RCIA-JASON13/kicad_tst/01_HPM5E00EVKRevC/02_投产资料/HPM5E00EVKRevC_投产资料/5E_EVK_BOM 2025.03.13.xls

5E_EVK_BOM 2025.03.13
null | References | Value | Footprint | ASSY_OPT | Company | Model | Quantity
1 | C5, C6, C10, C13, C14, C15, C17, C20, C25, C32, C39, C40, C44, C46, C49, C57, C59, C65, C66, C74, C75, C80, C84, C85, C88, C89, C91, C92, C93, C94, C95, C97, C99, C100, C101, C103, C105, C112, C114, C115, C116, C121, C122, C129, C131, C132, C133, C134, C135, C139, C140, C142, C143, C154, C172, C247, C248, C249, C250, C251, C253, C254, C255, C256, C257, C264，C12, C72, C73, C113, C124, C127 | 0.1uF,50V | C_0402_1005Metric |  | SAMSUNG(三星) | 0402B104K500NT | 72
2 | C83, C86, C87, C107, C108, C145, C146, C147, C148, C157, C158, C159, C160 | 10nF,50V | C_0402_1005Metric |  | SAMSUNG(三星) | CL05B103KB5NNNC | 13
3 | C110 | 2.2nF,50V | C_0402_1005Metric |  | SAMSUNG(三星) | CL05B222KB5NNNC | 1
4 | C53, C69, C70, C117, C138, C149, C150, C152, C161 | 1nF,2kV | C_1206_3216Metric |  | FH(风华) | 1206B102K202NT | 9
5 | C81, C82, C262, C263 | 12pF,50V | C_0402_1005Metric |  | YAGEO(国巨) | CC0402JRNPO9BN120 | 4
6 | C141, C144 | 18pF,50V | C_0402_1005Metric |  | YAGEO(国巨) | CC0402JRNPO9BN180 | 2
7 | C58, C67, C79 | 47pF,50V | C_0402_1005Metric |  | YAGEO(国巨) | CC0402JRNPO9BN470 | 3
8 | C21, C43 | 22pF,50V | C_0402_1005Metric |  | SAMSUNG(三星) | CL05C220JB5NNNC | 2
9
10 | C16, C258，C18, C27, C28, C33, C45, C47, C51, C52, C62, C68, C76, C77, C78, C98, C104, C106, C109, C119, C125, C156, C245, C246, C252 | 10uF,10V | C_0402_1005Metric |  | SAMSUNG(三星) | CL05A106MP5NUNC | 25
11 | C153，C2, C3, C4, C8, C22, C29, C30, C31, C54, C60, C130, C136, C137, C155 | 10uF,16V | C_0603_1608Metric |  | SAMSUNG(三星) | CL10A106KO8NQNC | 14
12 | C1, C7, C9, C19, C23, C24, C26, C41, C42, C50 | 22uF,16V | C_0805_2012Metric |  | SAMSUNG(三星) | CL21A226MOQNNNE | 10
13 | C90, C96, C102, C111 | 22uF,10V | C_0603_1608Metric |  | SAMSUNG(三星) | CL10A226MP8NUNE | 4
14 | C123 | 0.1uF,16V | C_0402_1005Metric | DNP | SAMSUNG(三星) | CL05B104KO5NNNC | 1
15 | C63, C120 | 0.1uF,50V | C_0402_1005Metric | DNP | SAMSUNG(三星) | 0402B104K500NT | 2
16 | C71, C118 | 1uF,10V | C_0402_1005Metric | DNP | SAMSUNG(三星) | CL05A105KP5NNNC | 2
17 | C55, C56, C61, C64, C126, C128, C151 | 10nF,50V | C_0402_1005Metric | DNP | SAMSUNG(三星) | CL05B103KB5NNNC | 7
18 | C34, C35, C36, C37, C38 | 47pF,50V | C_0402_1005Metric | DNP | YAGEO(国巨) | CC0402JRNPO9BN470 | 5
19 | C11, C48 | 62pF,50V | C_0402_1005Metric | DNP | SAMSUNG(三星) | CL05B104KO5NNNC | 2
20 | R46, R48, R50, R51, R61, R75, R102, R103, R108, R113, R114, R115, R123, R125, R127, R130, R132 | 0Ω | R_0402_1005Metric |  | YAGEO(国巨) | RC0402JR-070RL | 17
21 | R41, R66, R167, R168, R284, R290, R291 | 0Ω_0402 | R_0402_1005Metric |  | YAGEO(国巨) | RC0402JR-070RL | 7
22 | R2, R4 | 0Ω | R_0603_1608Metric |  | UNI-ROYAL(厚声) | 0603WAF0000T5E | 2
23 | R100 | 0Ω | R_0805_2012Metric |  | FH(风华) | RS-05000JT | 1
24 | R53, R67 | 60.4Ω_1206 | R_1206_3216Metric |  | UNI-ROYAL(厚声) | 1206W4F604JT5E | 2
25 | R54, R63 | 49.9Ω | R_0402_1005Metric |  | UNI-ROYAL(厚声) | 0402WGF499JTCE | 2
26 | R97, R109 | 10Ω | R_0402_1005Metric |  | UNI-ROYAL(厚声) | 0402WGF100JTCE | 2
27 | R3, R40, R43, R44, R45, R47, R52, R56, R65, R71, R73, R76, R94, R106, R107, R110, R133, R135, R140, R162, R163, R164, R165, R193, R194, R195, R196 | 33Ω | R_0402_1005Metric |  | UNI-ROYAL(厚声) | 0402WGF330JTCE | 27
28 | R80, R81, R82, R83, R158, R159, R160, R161, R180, R181, R182, R183 | 75Ω_0603 | R_0603_1608Metric |  | UNI-ROYAL(厚声) | 0603WAF750JT5E | 12
29 | R11, R85, R87, R112, R128, R155, R157, R287 | 330Ω | R_0402_1005Metric |  | UNI-ROYAL(厚声) | 0402WGF3300TCE | 8
30 | R169, R170, R171, R172, R173, R174, R175, R176 | 220Ω | R_0402_1005Metric |  | UNI-ROYAL(厚声) | 0402WGF2200TCE | 8
31 | R32, R33, R34, R35, R36 | 100Ω | R_0402_1005Metric |  | UNI-ROYAL(厚声) | 0402WGF1000TCE | 5
32 | R6 | 22Ω | R_0402_1005Metric |  | UNI-ROYAL(厚声) | 0402WGF220JTCE | 1
33 | R79, R153, R178 | 2.49K | R_0402_1005Metric |  | FH(风华) | RC-02W2491FT | 3
34 | R119 | 4.7K | R_0603_1608Metric |  | UNI-ROYAL(厚声) | 0603WAF4701T5E | 1
35 | R29, R62, R64, R84, R86, R122, R138, R139, R141, R142, R143, R144, R145, R146, R147, R148, R149, R151, R154, R156 | 4.7K | R_0402_1005Metric |  | UNI-ROYAL(厚声) | 0402WGF4701TCE | 20
36 | R292, R293 | 5.1K | R_0402_1005Metric |  | UNI-ROYAL(厚声) | 0402WGF5101TCE | 2
37 | R21, R22，R1, R8, R9, R10, R14, R16, R17, R23, R26, R37, R38, R39, R59, R72, R74, R89, R90, R96, R98, R99, R101, R111, R166, R179, R286, R288, R289, R296, R297, R299 | 10K | R_0402_1005Metric |  | UNI-ROYAL(厚声) | 0402WGF1002TCE | 32
38 | R24, R298 | 2K | R_0402_1005Metric |  | UNI-ROYAL(厚声) | 0402WGF2001TCE | 2
39 | R7, R55, R57, R58, R77, R104, R105, R200 | 1K | R_0402_1005Metric |  | UNI-ROYAL(厚声) | 0402WGF1001TCE | 8
40 | R192 | 33.2K | R_0402_1005Metric |  | UNI-ROYAL(厚声) | 0402WGF1003TCE | 1
41 | R285 | 12K | R_0402_1005Metric |  | UNI-ROYAL(厚声) | 0402WGF1202TCE | 1
42 | R12 | 100K | R_0402_1005Metric |  | UNI-ROYAL(厚声) | 0402WGF1003TCE | 1
43 | R93 | 1M | R_0402_1005Metric |  | UNI-ROYAL(厚声) | CQ02WGJ0105TCE | 1
44 | R42, R91, R92,R95 | 1M | R_1206_3216Metric |  | Viking(光颉) | ARG06BTC1004 | 4
45 | R88 | 10K | R_0402_1005Metric | DNP | UNI-ROYAL(厚声) | 0402WGF1002TCE | 1
46 | R116, R137 | 2.49K | R_0402_1005Metric | DNP | FH(风华) | RC-02W2491FT | 2
47 | R150, R152 | 4.7K | R_0402_1005Metric | DNP | UNI-ROYAL(厚声) | 0402WGF4701TCE | 2
48 | R49, R134 | 33Ω | R_0402_1005Metric | DNP | UNI-ROYAL(厚声) | 0402WGF330JTCE | 2
49 | R5, R25 | 0Ω | R_0603_1608Metric | DNP | UNI-ROYAL(厚声) | 0603WAF0000T5E | 2
50 | R18, R19 | 5.1K | R_0402_1005Metric | DNP | UNI-ROYAL(厚声) | 0402WGF5101TCE | 2
51 | R27, R28, R30, R117, R118, R120, R121, R124, R126, R129, R131, R136, R184, R185, R186, R187, R188, R189, R190, R191 | 0Ω | R_0402_1005Metric | DNP | YAGEO(国巨) | RC0402JR-070RL | 20
52 | R13, R15, R20, R31, R60, R68, R69, R70, R78, R177 | 0Ω_0402 | R_0402_1005Metric | DNP | YAGEO(国巨) | RC0402JR-070RL | 10
53 | D1 | 1N5819HW-7-F | D_SOD-123 | DNP | DIODES(美台) | 1N5819HW-7-F | 1
54 | U5 | MX25L12833FM2I-10G | SOIC8_208mil | DNP | MXIC(旺宏电子) | MX25L12833FM2I-10G | 1
55 | L1, L3, L4, L6 | 4.7uH_1.4A | L1008 |  | muRata(村田) | DFE252010F-4R7M | 4
56 | L2, L7 | DLW21SN900SQ2L | L2012 |  | muRata(村田) | DLW21SN900SQ2L | 2
57 | L5 | ACT45B-510-2P-TL003 | L4532 |  | TDK | ACT45B-510-2P-TL003 | 1
58 | D2, D15 | SS34A | D_SMA |  | YANGJIE(扬杰) | SS34A | 2
59 | D3, D5 | BAT54A-7-F | SOT-23 |  | DIODES(美台) | BAT54A-7-F | 2
60 | FB2, FB5, FB6, FB8,FB3, FB10 | 100Ω@100MHz 2A | R_0603_1608Metric |  | Sunlord(顺络) | PZ1608D101-2R0TF | 6
61 | FB1, FB4 | 100Ω@100MHz_2A | R_0805_2012Metric |  | Sunlord(顺络) | PZ2012U101-2R0TF | 2
62 | LED4 | SLR0365CRA1BD | LED-SEG-TH |  | SUNLIGHT(光华) | SLR0365CRA1BD/AFN-3651A | 1
63 | Q1 | 2N7002 | SOT-23 |  | CJ(江苏长电/长晶) | 2N7002 | 1
64 | LED8 | LED_GREEN | LED_0603 |  | 国星光电 | NCD0603C1 | 1
65 | LED1, LED2, LED5, LED6, LED7 | LED_RED | LED_0603 |  | 国星光电 | NCD0603R1 | 5
66 | D7 | NUP2105L | SOT-23 |  | TECH PUBLIC(台舟) | NUP2105L | 1
67 | U6, U29 | PW1515 | SOT-23-5 |  | 平芯微 | PW1515 | 2
68 | U7, U30 | PRTR5V0U2X | SOT-143 |  | TECH PUBLIC(台舟) | PRTR5V0U2X | 2
69 | U11, U22 | JL1111-N032I | QFN-32-1EP_5x5mm |  | JLSEMI/景略 | JL1111-N032I | 2
70 | U20, U21 | 74HC595D,118 | SOIC-16 |  | Nexperia(安世) | 74HC595D,118 | 2
71 | U1 | TPS563201DDCR | SOT-23-6 |  | TI | TPS563201DDCR | 1
72 | U2 | REF3033AIDBZR | SOT-23 |  | TI | REF3033AIDBZR | 1
73 | U3 | 74HC165D,653 | SOIC-16 |  | Nexperia(安世) | 74HC165D,653 | 1
74 | U4 | HPM5E31IGN1 | BGA-196_14x14 |  |  |  | 1
75
76 | U8 | AP2151WG-7 | SOT-23-5 |  | DIODES(美台) | AP2151WG-7 | 1
77 | U9 | NSI1306M25-DSWR | SOP-16_L10.3 |  | NOVOSENSE(纳芯微) | NSI1306M25-DSWR | 1
78 | U10 | CAT24C128WI-GT3 | SOIC-8 |  | onsemi(安森美) | CAT24C128WI-GT3 | 1
79 | U12 | TLV62569DBVR | SOT-23-5 |  | TI | TLV62569DBVR | 1
80 | U13 | LP5907MFX-3.3/NOPB | SOT-23-5 |  | TI | LP5907MFX-3.3/NOPB | 1
81 | U15 | RTL8211E-VB-CG | QFN-48-1EP_6x6mm |  | REALTEK(瑞昱) | RTL8211E-VB-CG | 1
82 | U16 | 网口变压器H5007NL | PULSE_H5007NL |  | PULSE | H5007NL | 1
83 | U17 | TJA1042T/3 | SOIC-8 |  | NXP(恩智浦) | TJA1042T/3 | 1
84 | U18 | DS18B20 | TO-92-3 |  | MSKSEMI(美森科) | DS18B20 | 1
85 | U28 | FT2232HL | LQFP-64 |  | FTDI(飞特帝亚) | FT2232HL | 1
86 | U31 | 93LC56B-I/SN | SOIC-8 |  | MICROCHIP(美国微芯) | 93LC56B-I/SN | 1
87 | X2 | 24MHz ±10ppm 12pF | 3225 |  | EPSON(爱普生) | X1E0000210129 | 1
88 | X5 | 25MHz_±10ppm_12pF | 3225 |  | YXC(扬兴晶振) | X322525MOB4SI | 1
89 | X6 | 12MHz ±10ppm 10pF | 3225 |  | HCI(杭晶) | XC32M4-12.000-F10NNFT | 1
90 | SW2, SW4, SW5, SW7, SW8, SW9, SW10, SW11, SW12 | 轻触开关4.5mm*4.5mm*4mm | 轻触开关SMD-4P,4.5x4.5mm |  | SHOU HAN(首韩) | TS4540TP | 9
91 | SW1, SW6 | 拨码开关 | SW-SMD_DM-02-V |  | 圜达 | DM-02-V | 2
92 | SW3 | 轻触开关 | 轻触开关SMD-4P,4.5x4.5mm |  | E-Switch | TL3305AF260QG | 1
93 | T3, T30 | 网口变压器11FB-05NL | H1102_XFMR16_SM |  | YDS(元册科技) | 11FB-05NL | 2
94 | CN1 | 3113-112T | SMD_98P-P1.00-V_3133 |  | UMaxconn(友贸) | 3113-112T | 1
95 | J1, J16 | USB_Type-C | TYPE-C-16P |  | kinghelm(金航标) | KH-TYPE-C-16P | 2
96 | J4, J5 | SMA内孔弯座 | SMA-弯座 |  | kinghelm(金航标) | KH-SMA-K513-G | 2
97 | J6, J8 | 测试针 | 探针 |  | Keystone | 4952 | 2
98 | J7 | KF2EDGR_3.81_3P | 3.81_1x03_P3.81mm |  | BOOMELE(博穆精密) | 2.54-1*40P直针 | 1
99 | J10 | 2.54-2*10P简牛 | IDC-Header_2x10_P2.54mm |  | BOOMELE(博穆精密) | 2.54-2*10P简牛 | 1
100 | P1, P2,P3 | RJ45 | RJ45-TH_B-1-1_led-update |  | BOOMELE(博穆精密) | RJ45-B-1*1 | 2
101 | JP1, JP2, JP4, JP5, JP6, JP7, JP8, JP21 | Jumper_2 | 1x02_P2.54mm_Vertical |  |  | 跳帽 | 8
102 | JP3 | Jumper_3_Bridged12 | 1x03_P2.54mm_Vertical |  |  | 跳帽(2-3) | 1
103 | J17 | Conn_01x10 | 1x10_P2.54mm_Vertical |  | XFCN(兴飞) | PZ254V-11-06P | 1
104 | P5 | 双排排针2.54mm-40P | 2x20_P2.54mm_Vertical |  | BOOMELE(博穆精密) | 2.54mm 2*20P直排针 | 1
105 | J3 | Conn_02x16_90° | 2x16_P2.54mm_Horizontal |  | BOOMELE(博穆精密) | 2.54-2*16P弯针 | 1
