RCIA-JASON13/kicad_tst/01_HPM5E00EVKRevC/02_投产资料/HPM5E00EVKRevC_投产资料/外观图.pdf

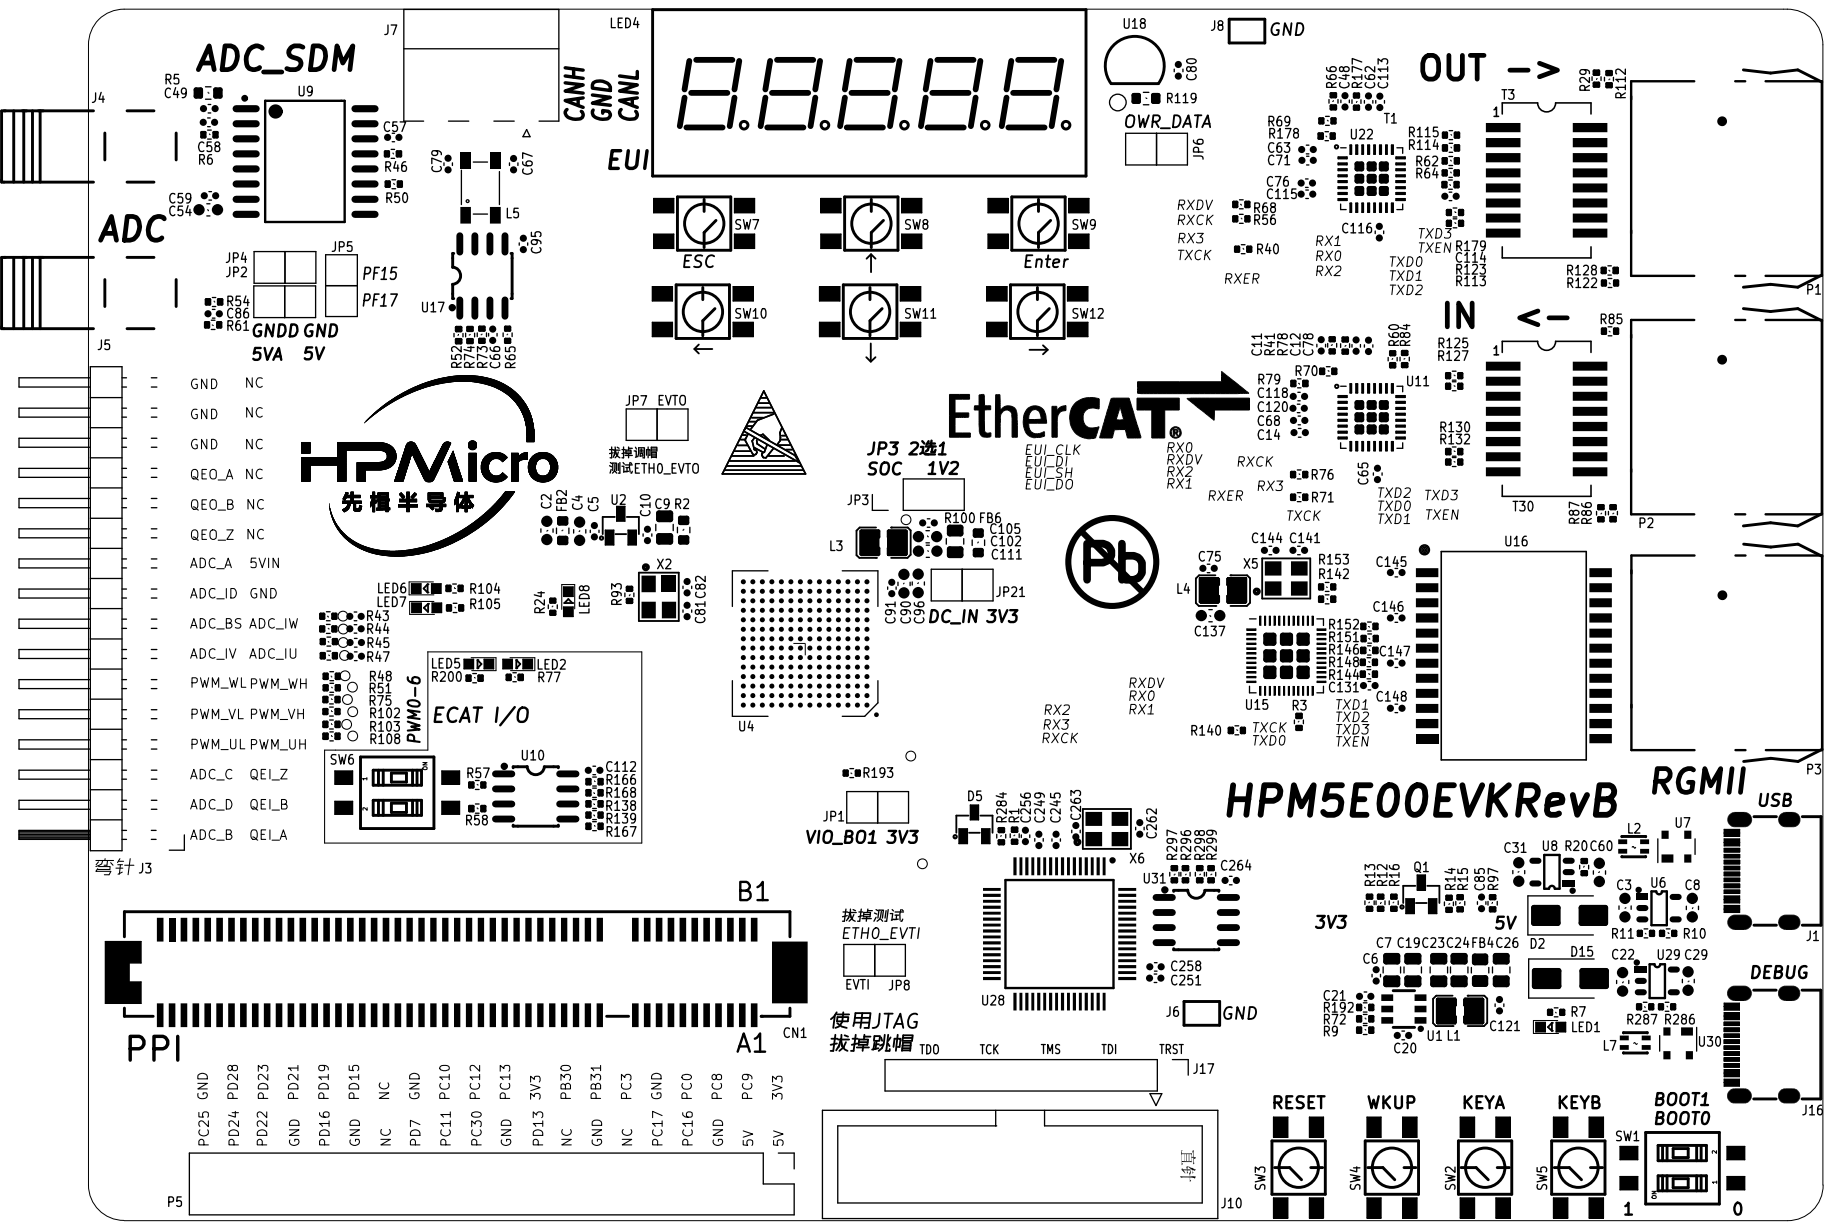
[picture p1: page 1]
