RCIA-JASON13/kicad_tst/01_HPM5E00EVKRevC/01_工程文件/HPM5E00EVKRevC/01.MAIN.kicad_sch

## KiCad design 01_HPM5E00EVKRevC/01_工程文件/HPM5E00EVKRevC/01.MAIN.kicad_sch (2026-01-12)

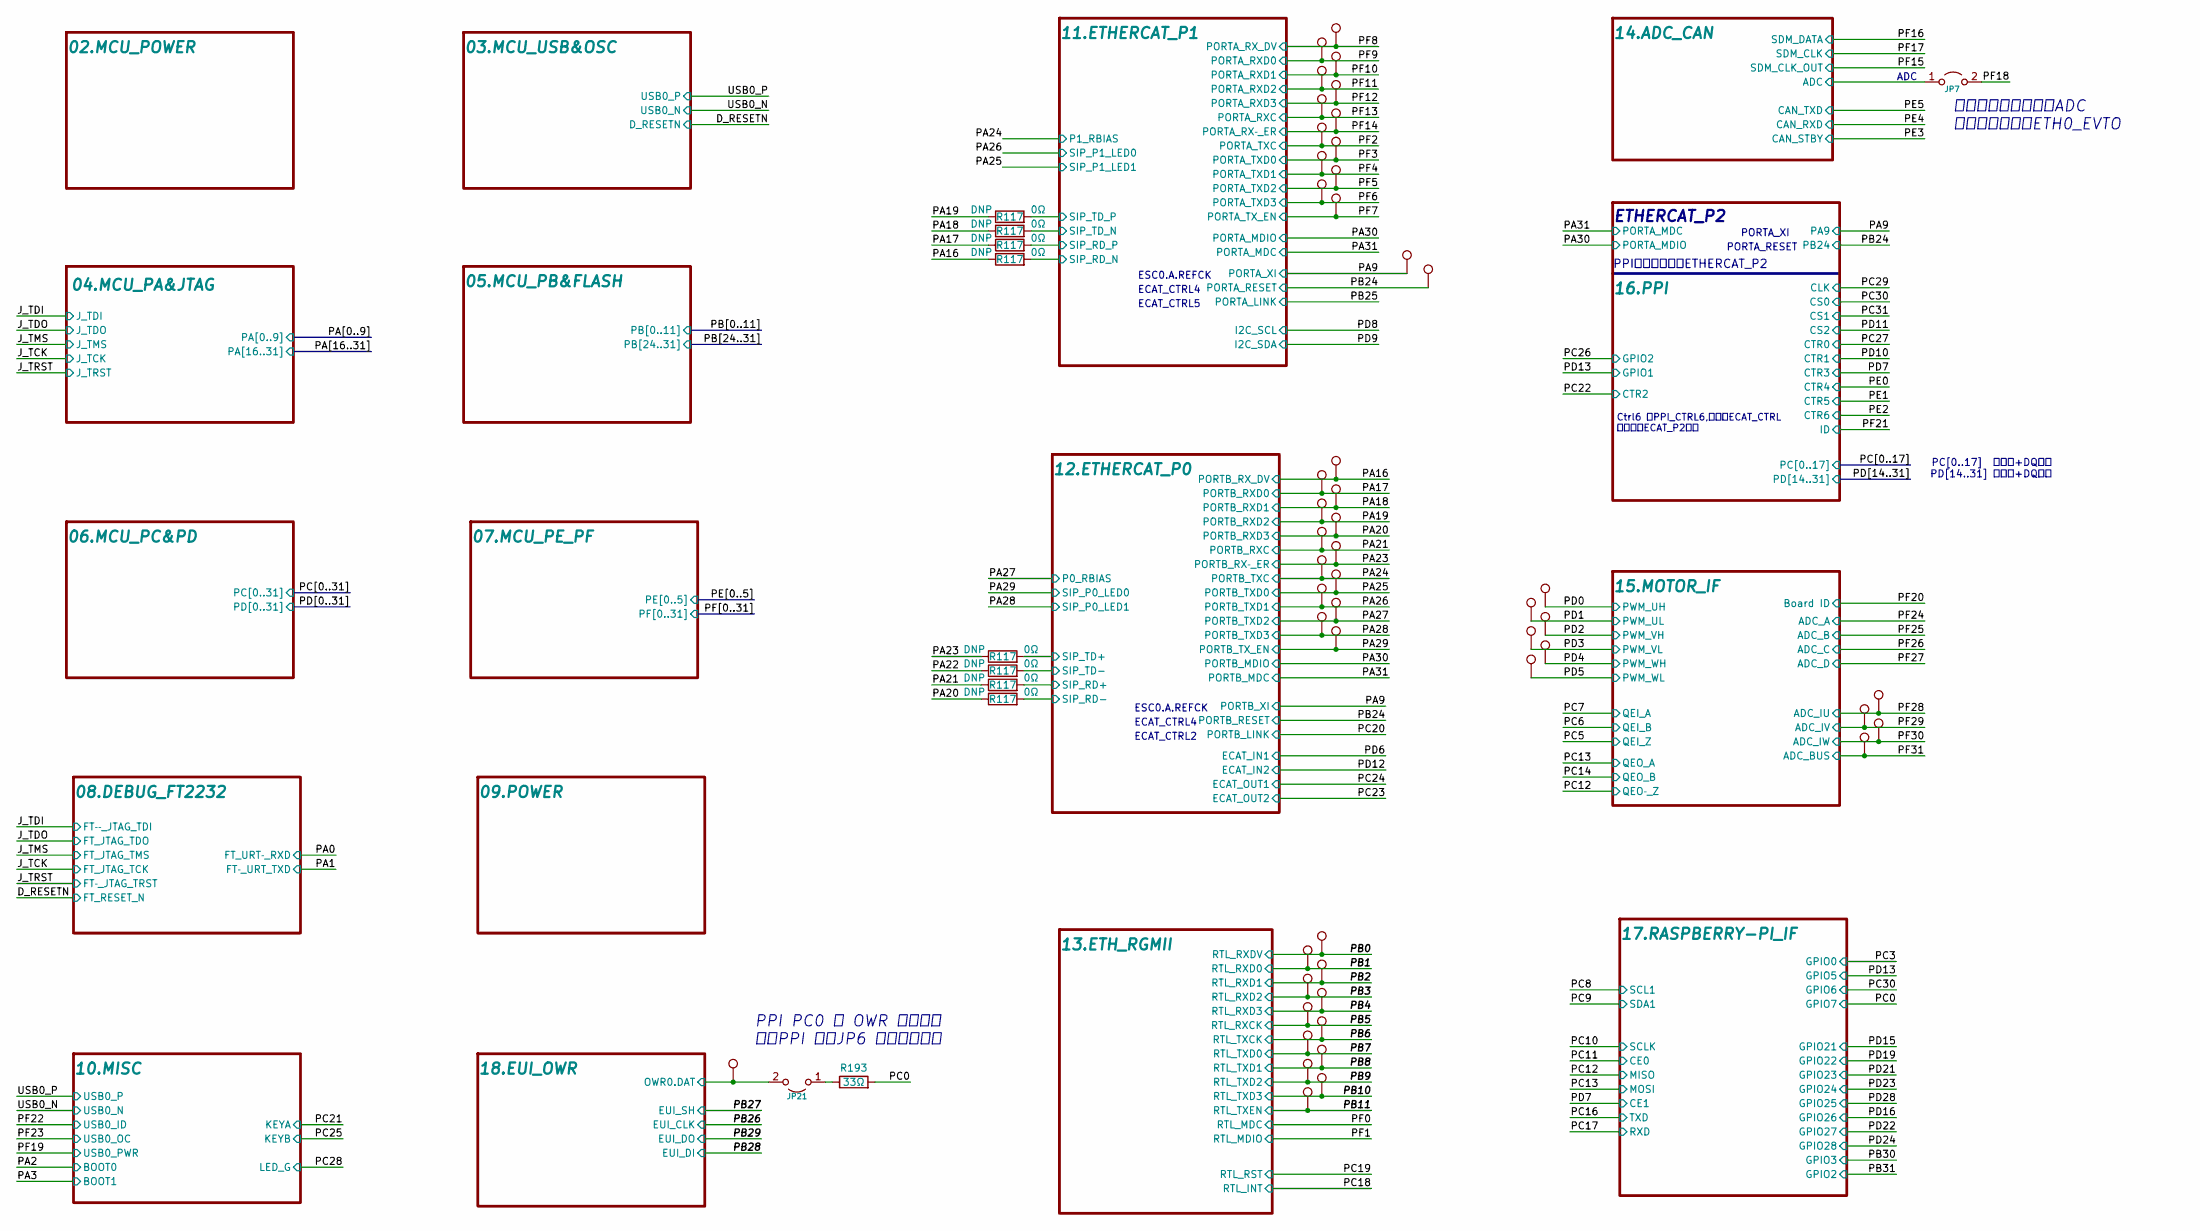
[picture p2: schematic 01.MAIN.kicad_sch]

Parts:
JP7, JP21: Jumper_2; PinHeader_1x02_P2.54mm_Vertical
R117: 0Ω; R_0402_1005Metric
R193: 33Ω; R_0402_1005Metric
TP1, TP2, TP3, TP4, TP5, TP6, TP7, TP8, TP9, TP10, TP11, TP12, TP13, TP14, TP15, TP16, TP17, TP18, TP19, TP20, TP21, TP22, TP23, TP24, TP25, TP26, TP27, TP28, TP29, TP30, TP31, TP32, TP33, TP34, TP35, TP36, TP37, TP38, TP46, TP47, TP48, TP49, TP50, TP51, TP52, TP53, TP54, TP55, TP56, TP57: 0.5mm; TestPoint_Pad_D0.5mm
TP42: 1.0mm; TestPoint_Pad_D1.0mm

Connections:
ADC: JP7.1 (A)
unnamed: JP21.1 (A), R193.1
OWR0.DAT: JP21.2 (B), TP42.1
PA9: TP46.1
PA16: R117.1, TP13.1
PA17: R117.1, TP14.1
PA18: R117.1, TP15.1
PA19: R117.1, TP16.1
PA20: R117.1, TP17.1
PA21: R117.1, TP18.1
PA22: R117.1
PA23: R117.1, TP19.1
PA24: TP20.1
PA25: TP21.1
PA26: TP22.1
PA27: TP23.1
PA28: TP24.1
PA29: TP25.1
PB0: TP1.1
PB1: TP2.1
PB2: TP3.1
PB3: TP4.1
PB4: TP5.1
PB5: TP6.1
PB6: TP7.1
PB7: TP8.1
PB8: TP9.1
PB9: TP10.1
PB10: TP11.1
PB11: TP12.1
PB24: TP47.1
PC0: R193.2
PD0: TP48.1
PD1: TP49.1
PD2: TP50.1
PD3: TP51.1
PD4: TP52.1
PD5: TP53.1
PF2: TP33.1
PF3: TP34.1
PF4: TP35.1
PF5: TP36.1
PF6: TP37.1
PF7: TP38.1
PF8: TP26.1
PF9: TP27.1
PF10: TP28.1
PF11: TP29.1
PF12: TP30.1
PF13: TP31.1
PF14: TP32.1
PF18: JP7.2 (B)
PF28: TP54.1
PF29: TP55.1
PF30: TP56.1
PF31: TP57.1
SIP_RD+: R117.2
SIP_RD-: R117.2
SIP_RD_N: R117.2
SIP_RD_P: R117.2
SIP_TD+: R117.2
SIP_TD-: R117.2
SIP_TD_N: R117.2
SIP_TD_P: R117.2

Notes on the sheet:
Ctrl6 是PPI_CTRL6,同时是ECAT_CTRL 该引脚给ECAT_P2使用
PPI PC0 与 OWR 引脚重合 测试PPI 时候JP6 不要插上跳冒
ECAT_CTRL5
PORTA_XI
插上跳冒，默认测试ADC 拔掉调帽，测试ETH0_EVTO
PPI子卡上会增加ETHERCAT_P2
ECAT_CTRL4
PC[0..17] 数据线+DQ等长 PD[14..31] 数据线+DQ等长
ESC0.A.REFCK
ECAT_CTRL4
PORTA_RESET
ADC
ECAT_CTRL2
ETHERCAT_P2
