RCIA-JASON13/kicad_tst/01_HPM5E00EVKRevC/01_工程文件/HPM5E00EVKRevC/02.MCU_POWER.kicad_sch

## KiCad design 01_HPM5E00EVKRevC/01_工程文件/HPM5E00EVKRevC/02.MCU_POWER.kicad_sch (2026-01-12)

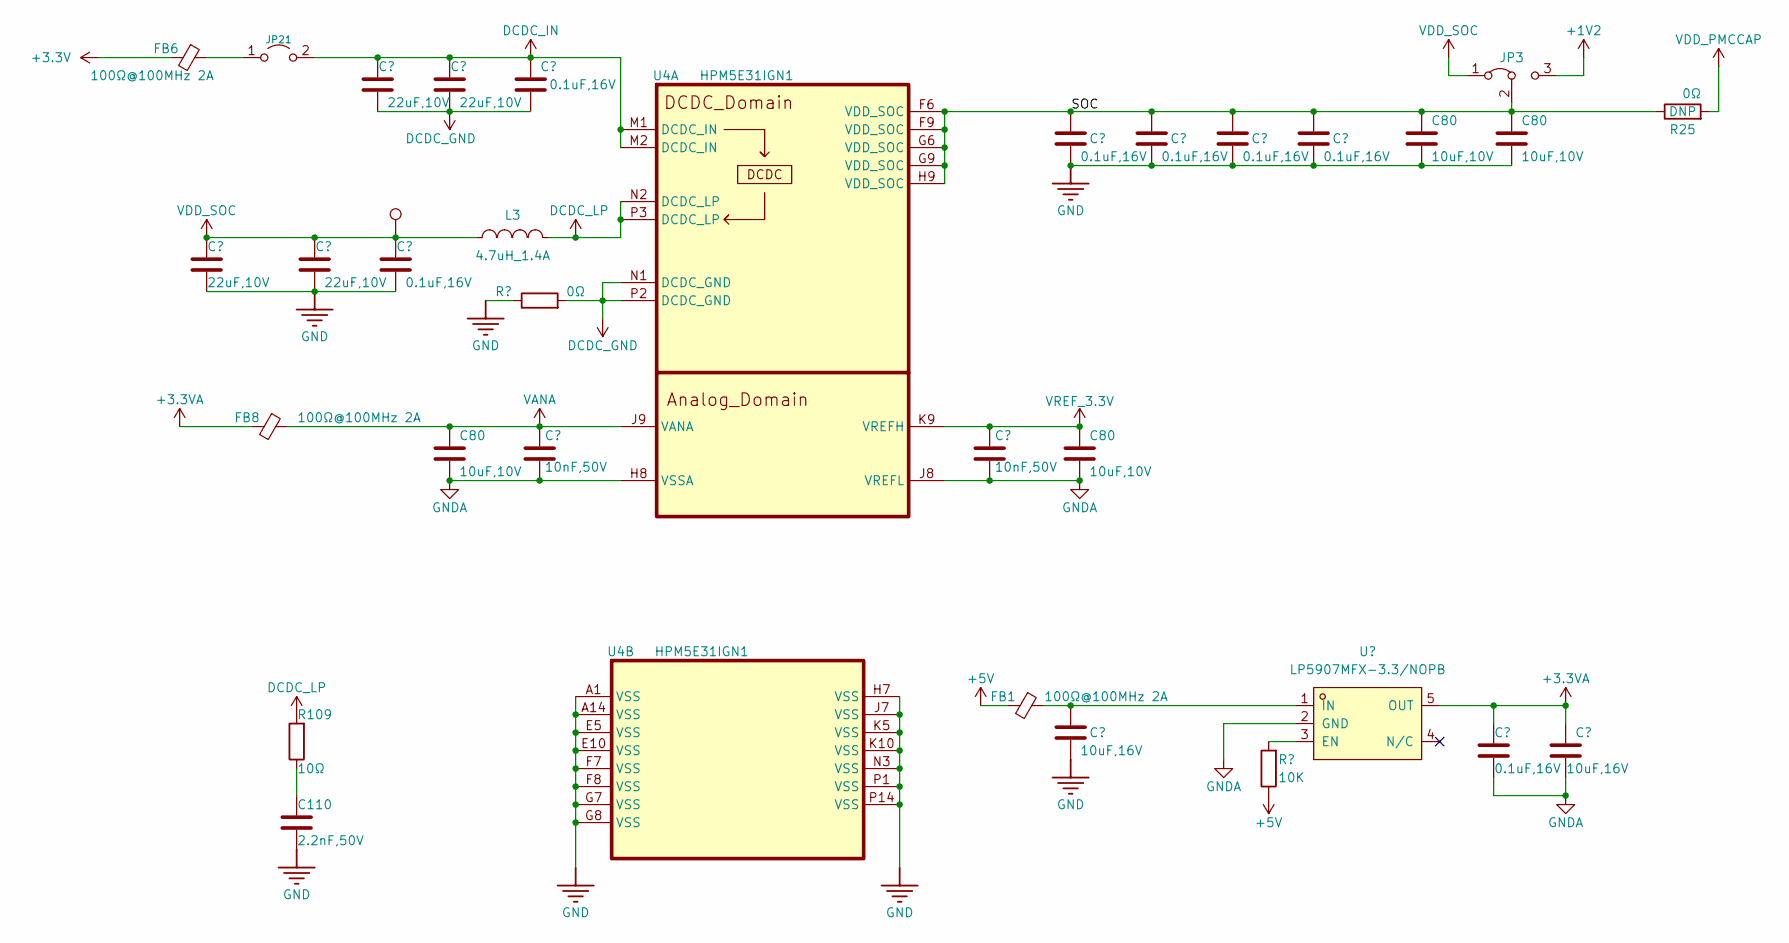
[picture p3: schematic 02.MCU_POWER.kicad_sch]

Parts:
C1, C7: 10uF,16V; C_0603_1608Metric
C6, C91, C92, C93, C94, C97, C105: 0.1uF,16V; C_0402_1005Metric
C80: 10uF,10V; C_0402_1005Metric
C90, C96, C102, C111: 22uF,10V; C_0603_1608Metric
C110: 2.2nF,50V; C_0402_1005Metric
C145: 10nF,50V; C_0402_1005Metric
FB1, FB6, FB8: 100Ω@100MHz 2A; R_0603_1608Metric
JP3: Jumper_3_Bridged12; PinHeader_1x03_P2.54mm_Vertical
JP21: Jumper_2; PinHeader_1x02_P2.54mm_Vertical
L3: 4.7uH_1.4A; L1008
R1: 10K; R_0402_1005Metric
R25: 0Ω; R_0603_1608Metric
R100: 0Ω; R_0805_2012Metric
R109: 10Ω; R_0402_1005Metric
TP58: 0.5mm; TestPoint_Pad_D0.5mm
U1: LP5907MFX-3.3/NOPB; SOT-23-5
U4: HPM5E31IGN1; BGA-196_14x14_12.0x12.0mm_P0.8mm

Connections:
+1V2: JP3.3 (B)
+3.3V: FB6.2
+3.3VA: C6.1, C7.1, FB8.2, U1.5 (OUT)
+5V: FB1.2, R1.1
DCDC_GND: C90.2, C91.2, C96.2, R100.2, U4.N1 (DCDC_GND), U4.P2 (DCDC_GND)
DCDC_IN: C90.1, C91.1, C96.1, JP21.2 (B), U4.M1 (DCDC_IN), U4.M2 (DCDC_IN)
DCDC_LP: L3.2, R109.2, U4.N2 (DCDC_LP), U4.P3 (DCDC_LP)
GND: C1.2, C80.2, C92.2, C93.2, C94.2, C97.2, C102.2, C105.2, C110.2, C111.2, R100.1, U4.A1 (VSS), U4.A14 (VSS), U4.E5 (VSS), U4.E10 (VSS), U4.F7 (VSS), U4.F8 (VSS), U4.G7 (VSS), U4.G8 (VSS), U4.H7 (VSS), U4.J7 (VSS), U4.K5 (VSS), U4.K10 (VSS), U4.N3 (VSS), U4.P1 (VSS), U4.P14 (VSS)
GNDA: C6.2, C7.2, C80.2, C145.2, U1.2 (GND), U4.H8 (VSSA), U4.J8 (VREFL)
unnamed: C1.1, FB1.1, U1.1 (IN)
unnamed: C110.1, R109.1
unnamed: FB6.1, JP21.1 (A)
unnamed: R1.2, U1.3 (EN)
SOC: C80.1, C92.1, C93.1, C94.1, C97.1, JP3.2 (C), R25.1, U4.F6 (VDD_SOC), U4.F9 (VDD_SOC), U4.G6 (VDD_SOC), U4.G9 (VDD_SOC), U4.H9 (VDD_SOC)
VANA: C80.1, C145.1, FB8.1, U4.J9 (VANA)
VDD_PMCCAP: R25.2
VDD_SOC: C102.1, C105.1, C111.1, JP3.1 (A), L3.1, TP58.1
VREF_3.3V: C80.1, C145.1, U4.K9 (VREFH)
