RCIA-JASON13/kicad_tst/01_HPM5E00EVKRevC/01_工程文件/HPM5E00EVKRevC/03.MCU_USB&OSC.kicad_sch

## KiCad design 01_HPM5E00EVKRevC/01_工程文件/HPM5E00EVKRevC/03.MCU_USB&OSC.kicad_sch (2026-01-12)

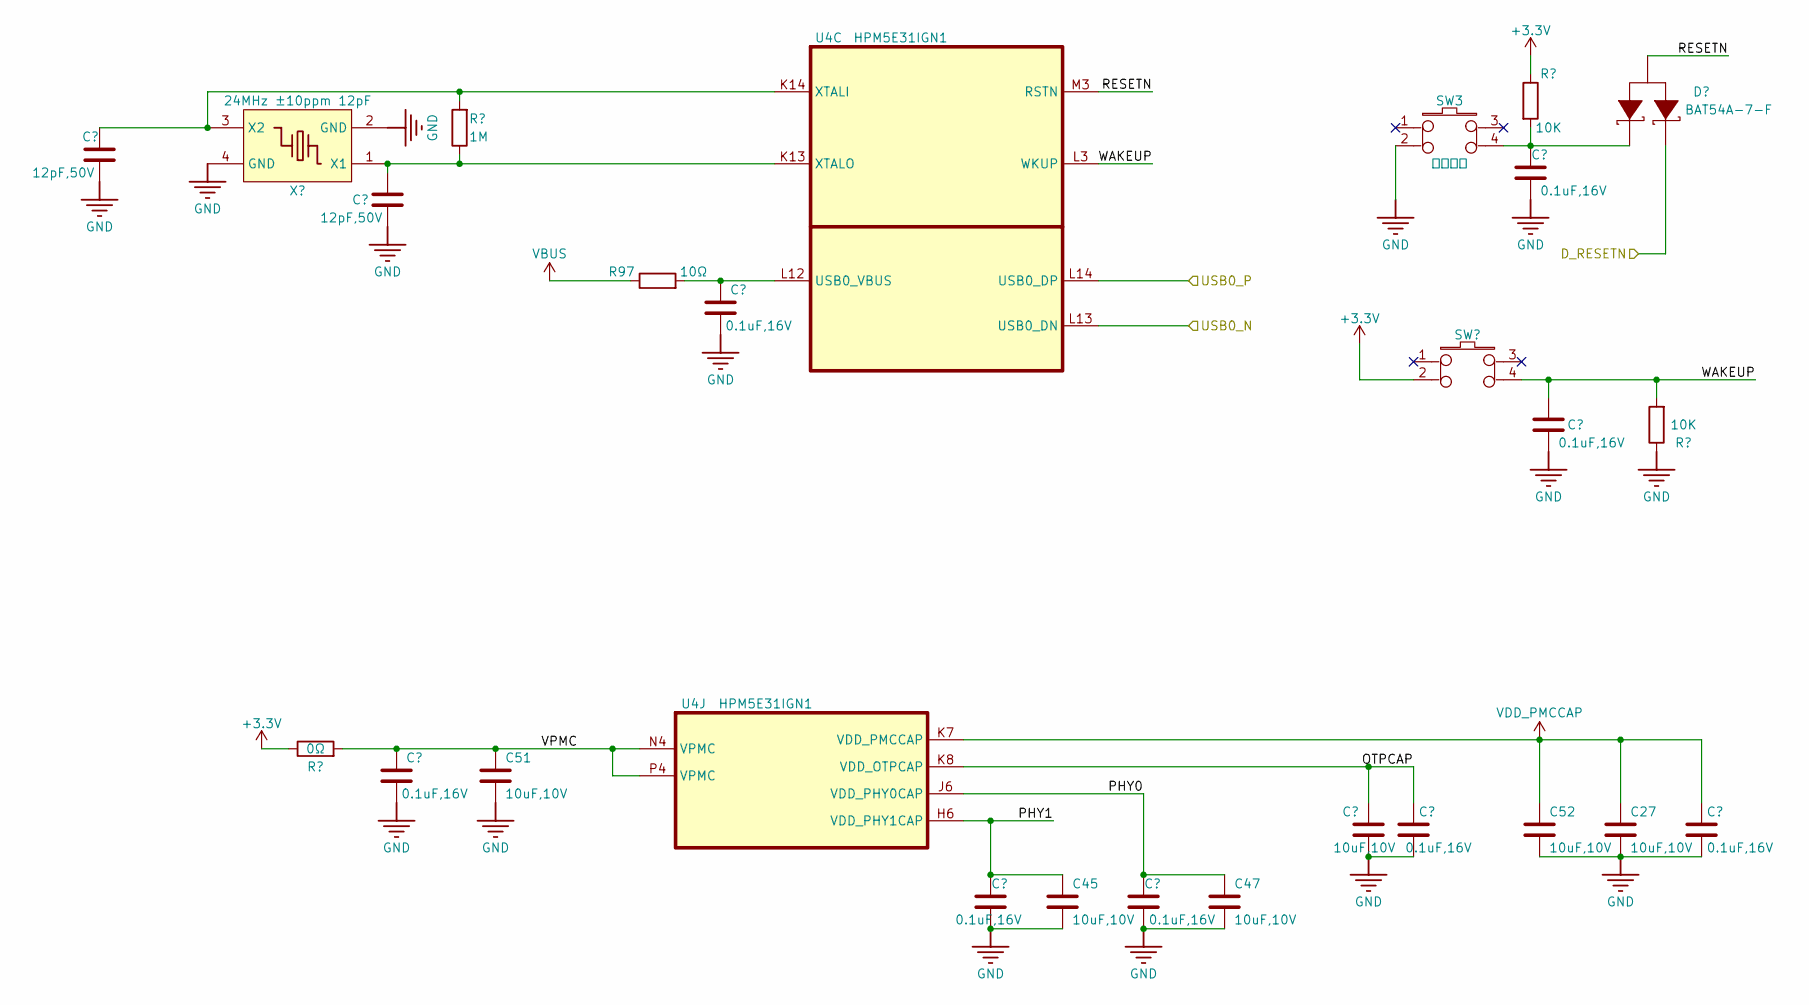
[picture p4: schematic 03.MCU_USB&OSC.kicad_sch]

Parts:
C13, C17, C40, C44, C46, C85, C88, C89: 0.1uF,16V; C_0402_1005Metric
C16, C27, C45, C47, C51, C52: 10uF,10V; C_0402_1005Metric
C81, C82: 12pF,50V; C_0402_1005Metric
D5: BAT54A-7-F; SOT-23
R4: 0Ω; R_0603_1608Metric
R93: 1M; R_0402_1005Metric
R97: 10Ω; R_0402_1005Metric
R98, R99: 10K; R_0402_1005Metric
SW3: 轻触开关; 轻触开关SMD-4P,4.5x4.5mm
SW4: 轻触开关4.5mm*4.5mm*4mm; 轻触开关SMD-4P,4.5x4.5mm
U4: HPM5E31IGN1; BGA-196_14x14_12.0x12.0mm_P0.8mm
X2: 24MHz ±10ppm 12pF; 3225

Connections:
+3.3V: R4.1, R98.1, SW4.2
D_RESETN: D5.2 (A)
GND: C13.1, C16.2, C17.2, C27.2, C40.2, C44.2, C45.2, C46.2, C47.2, C51.2, C52.2, C81.2, C82.2, C85.2, C88.2, C89.2, R99.1, SW3.2, X2.2 (GND), X2.4 (GND)
unnamed: C81.1, R93.2, U4.K14 (XTALI), X2.3 (X2)
unnamed: C82.1, R93.1, U4.K13 (XTALO), X2.1 (X1)
unnamed: C85.1, R97.2, U4.L12 (USB0_VBUS)
unnamed: C88.1, D5.1 (A), R98.2, SW3.4
OTPCAP: C16.1, C17.1, U4.K8 (VDD_OTPCAP)
PHY0: C46.1, C47.1, U4.J6 (VDD_PHY0CAP)
PHY1: C44.1, C45.1, U4.H6 (VDD_PHY1CAP)
RESETN: D5.3 (K), U4.M3 (RSTN)
USB0_N: U4.L13 (USB0_DN)
USB0_P: U4.L14 (USB0_DP)
VBUS: R97.1
VDD_PMCCAP: C27.1, C40.1, C52.1, U4.K7 (VDD_PMCCAP)
VPMC: C13.2, C51.1, R4.2, U4.N4 (VPMC), U4.P4 (VPMC)
WAKEUP: C89.1, R99.2, SW4.4, U4.L3 (WKUP)
