RCIA-JASON13/kicad_tst/01_HPM5E00EVKRevC/01_工程文件/HPM5E00EVKRevC/04.MCU_PA&JTAG.kicad_sch

## KiCad design 01_HPM5E00EVKRevC/01_工程文件/HPM5E00EVKRevC/04.MCU_PA&JTAG.kicad_sch (2026-01-12)

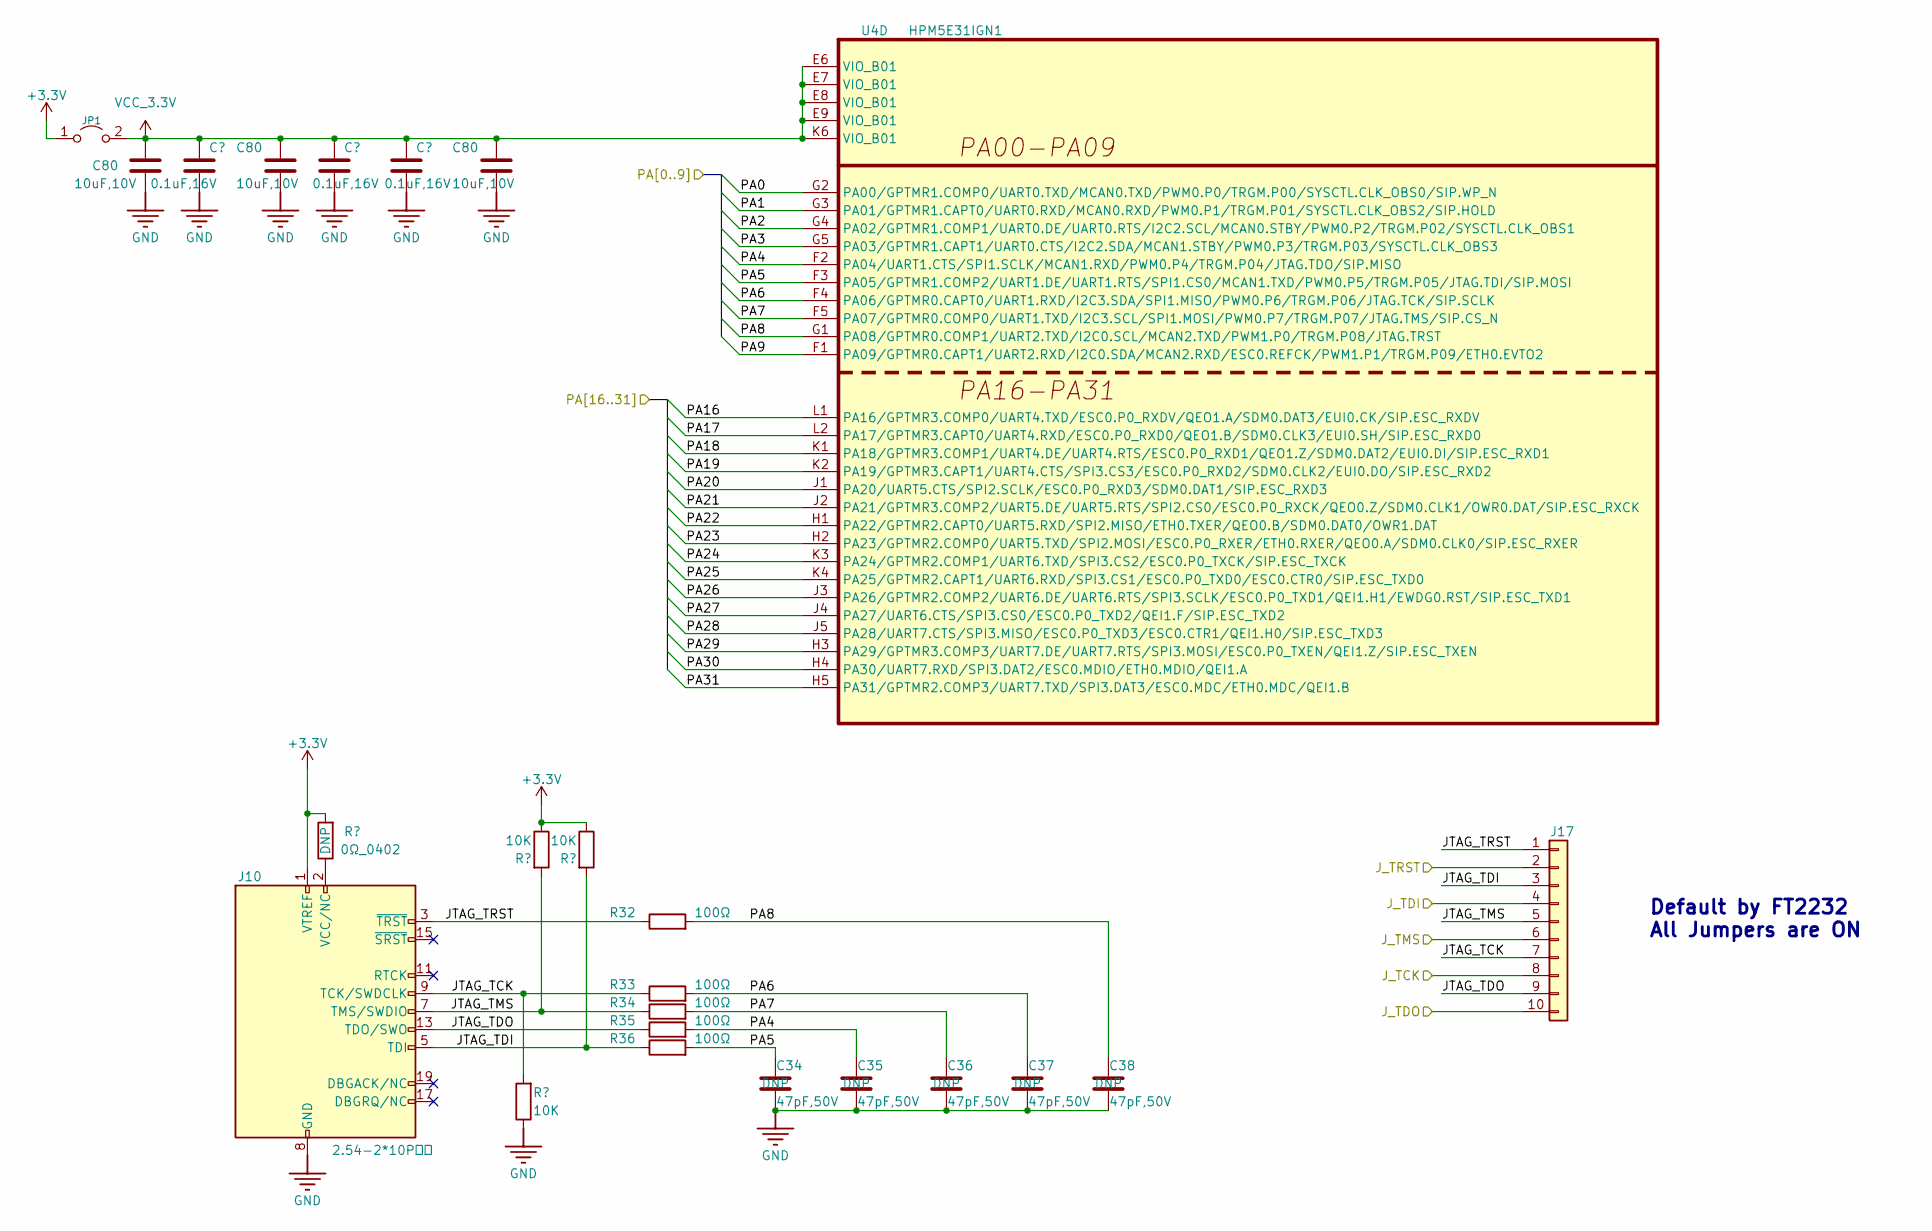
[picture p5: schematic 04.MCU_PA&JTAG.kicad_sch]

Parts:
C25, C84, C99: 0.1uF,16V; C_0402_1005Metric
C34, C35, C36, C37, C38: 47pF,50V; C_0402_1005Metric
C80: 10uF,10V; C_0402_1005Metric
J10: 2.54-2*10P简牛; IDC-Header_2x10_P2.54mm
J17: Conn_01x10; PinHeader_1x10_P2.54mm_Vertical
JP1: Jumper_2; PinHeader_1x02_P2.54mm_Vertical
R31: 0Ω_0402; R_0402_1005Metric
R32, R33, R34, R35, R36: 100Ω; R_0402_1005Metric
R37, R38, R39: 10K; R_0402_1005Metric
U4: HPM5E31IGN1; BGA-196_14x14_12.0x12.0mm_P0.8mm

Connections:
+3.3V: J10.1 (VTREF), JP1.1 (A), R31.2, R38.1, R39.1
GND: C25.1, C34.2, C35.2, C36.2, C37.2, C38.2, C80.2, C84.1, C99.1, J10.8 (GND), R37.1
JTAG_TCK: J10.9 (TCK/SWDCLK), J17.7, R33.1, R37.2
JTAG_TDI: J10.5 (TDI), J17.3, R36.1, R39.2
JTAG_TDO: J10.13 (TDO/SWO), J17.9, R35.1
JTAG_TMS: J10.7 (TMS/SWDIO), J17.5, R34.1, R38.2
JTAG_TRST: J10.3 (~TRST), J17.1, R32.1
J_TCK: J17.8
J_TDI: J17.4
J_TDO: J17.10
J_TMS: J17.6
J_TRST: J17.2
unnamed: J10.2 (VCC/NC), R31.1
PA0: U4.G2 (PA00/GPTMR1.COMP0/UART0.TXD/MCAN0.TXD/P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)
PA1: U4.G3 (PA01/GPTMR1.CAPT0/UART0.RXD/MCAN0.RXD/P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)
PA2: U4.G4 (PA02/GPTMR1.COMP1/UART0.DE/UART0.RTS/I2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)
PA3: U4.G5 (PA03/GPTMR1.CAPT1/UART0.CTS/I2C2.SDA/MC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)
PA4: C35.1, R35.2, U4.F2 (PA04/UART1.CTS/SPI1.SCLK/MCAN1.RXD/PWM0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)
PA5: C34.1, R36.2, U4.F3 (PA05/GPTMR1.COMP2/UART1.DE/UART1.RTS/SP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)
PA6: C37.1, R33.2, U4.F4 (PA06/GPTMR0.CAPT0/UART1.RXD/I2C3.SDA/SP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)
PA7: C36.1, R34.2, U4.F5 (PA07/GPTMR0.COMP0/UART1.TXD/I2C3.SCL/SP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)
PA8: C38.1, R32.2, U4.G1 (PA08/GPTMR0.COMP1/UART2.TXD/I2C0.SCL/MC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)
PA9: U4.F1 (PA09/GPTMR0.CAPT1/UART2.RXD/I2C0.SDA/MC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)
PA16: U4.L1 (PA16/GPTMR3.COMP0/UART4.TXD/ESC0.P0_RXD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)
PA17: U4.L2 (PA17/GPTMR3.CAPT0/UART4.RXD/ESC0.P0_RXD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)
PA18: U4.K1 (PA18/GPTMR3.COMP1/UART4.DE/UART4.RTS/ES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)
PA19: U4.K2 (PA19/GPTMR3.CAPT1/UART4.CTS/SPI3.CS3/ES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)
PA20: U4.J1 (PA20/UART5.CTS/SPI2.SCLK/ESC0.P0_RXD3/S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)
PA21: U4.J2 (PA21/GPTMR3.COMP2/UART5.DE/UART5.RTS/SP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)
PA22: U4.H1 (PA22/GPTMR2.CAPT0/UART5.RXD/SPI2.MISO/E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)
PA23: U4.H2 (PA23/GPTMR2.COMP0/UART5.TXD/SPI2.MOSI/E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)
PA24: U4.K3 (PA24/GPTMR2.COMP1/UART6.TXD/SPI3.CS2/ES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)
PA25: U4.K4 (PA25/GPTMR2.CAPT1/UART6.RXD/SPI3.CS1/ES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)
PA26: U4.J3 (PA26/GPTMR2.COMP2/UART6.DE/UART6.RTS/SP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)
PA27: U4.J4 (PA27/UART6.CTS/SPI3.CS0/ESC0.P0_TXD2/QE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)
PA28: U4.J5 (PA28/UART7.CTS/SPI3.MISO/ESC0.P0_TXD3/E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)
PA29: U4.H3 (PA29/GPTMR3.COMP3/UART7.DE/UART7.RTS/SP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)
PA30: U4.H4 (PA30/UART7.RXD/SPI3.DAT2/ESC0.MDIO/ETH0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)
PA31: U4.H5 (PA31/GPTMR2.COMP3/UART7.TXD/SPI3.DAT3/E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)
VCC_3.3V: C25.2, C80.1, C84.2, C99.2, JP1.2 (B), U4.E6 (VIO_B01), U4.E7 (VIO_B01), U4.E8 (VIO_B01), U4.E9 (VIO_B01), U4.K6 (VIO_B01)

Notes on the sheet:
Default by FT2232 All Jumpers are ON
