RCIA-JASON13/kicad_tst/01_HPM5E00EVKRevC/01_工程文件/HPM5E00EVKRevC/05.MCU_PB&FLASH.kicad_sch

## KiCad design 01_HPM5E00EVKRevC/01_工程文件/HPM5E00EVKRevC/05.MCU_PB&FLASH.kicad_sch (2026-01-12)

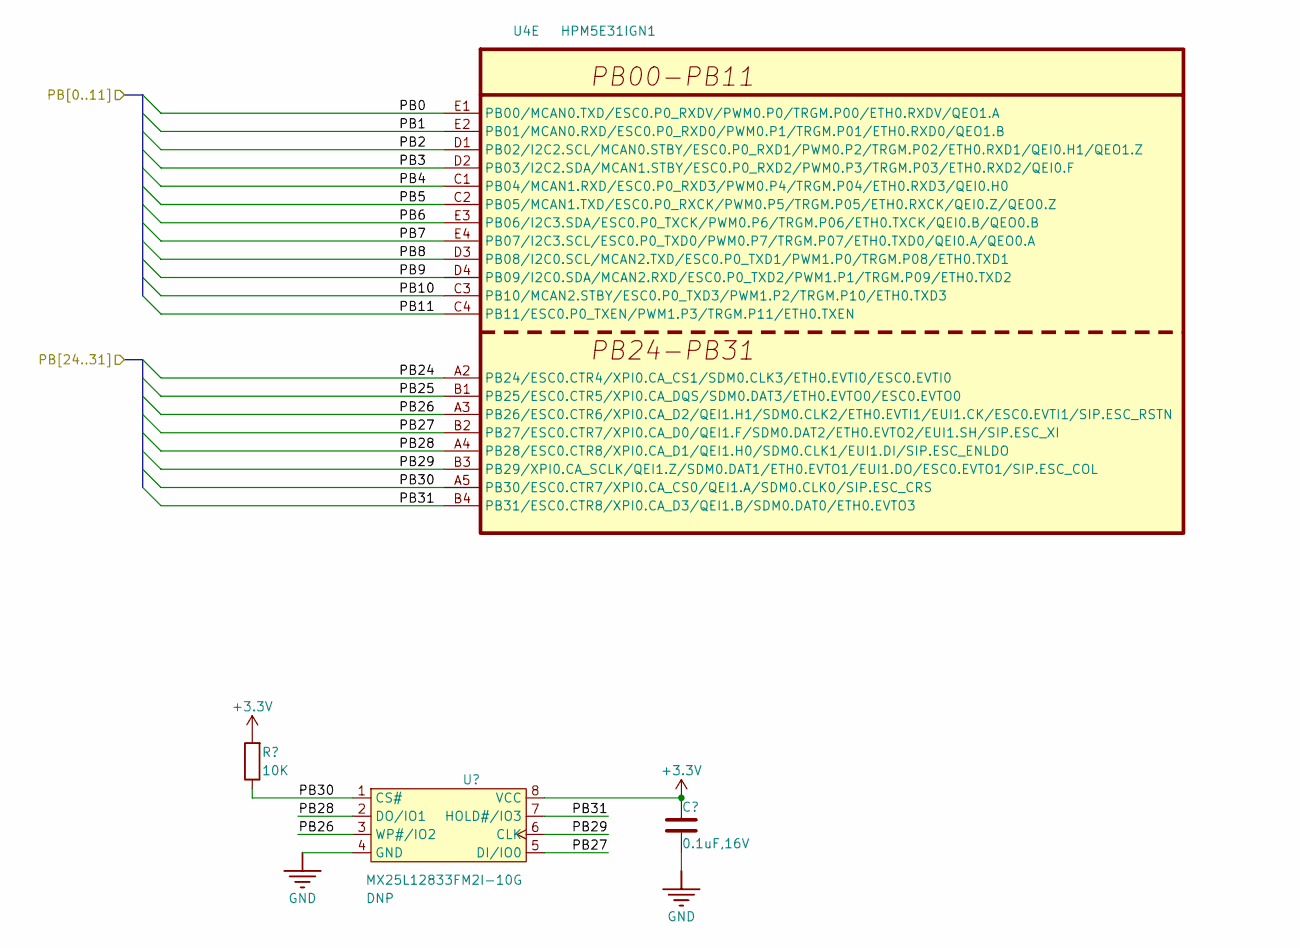
[picture p6: schematic 05.MCU_PB&FLASH.kicad_sch]

Parts:
C48: 0.1uF,16V; C_0402_1005Metric
R49: 10K; R_0402_1005Metric
U4: MX25L12833FM2I-10G; SOIC8_208mil

Connections:
+3.3V: C48.1, R49.2, U4.8 (VCC)
GND: C48.2, U4.4 (GND)
PB0: U4.E1 (PB00/MCAN0.TXD/ESC0.P0_RXDV/PWM0.P0/TRG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)
PB1: U4.E2 (PB01/MCAN0.RXD/ESC0.P0_RXD0/PWM0.P1/TRG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)
PB2: U4.D1 (PB02/I2C2.SCL/MCAN0.STBY/ESC0.P0_RXD1/P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)
PB3: U4.D2 (PB03/I2C2.SDA/MCAN1.STBY/ESC0.P0_RXD2/P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)
PB4: U4.C1 (PB04/MCAN1.RXD/ESC0.P0_RXD3/PWM0.P4/TRG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)
PB5: U4.C2 (PB05/MCAN1.TXD/ESC0.P0_RXCK/PWM0.P5/TRG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)
PB6: U4.E3 (PB06/I2C3.SDA/ESC0.P0_TXCK/PWM0.P6/TRGM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)
PB7: U4.E4 (PB07/I2C3.SCL/ESC0.P0_TXD0/PWM0.P7/TRGM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)
PB8: U4.D3 (PB08/I2C0.SCL/MCAN2.TXD/ESC0.P0_TXD1/PW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)
PB9: U4.D4 (PB09/I2C0.SDA/MCAN2.RXD/ESC0.P0_TXD2/PW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)
PB10: U4.C3 (PB10/MCAN2.STBY/ESC0.P0_TXD3/PWM1.P2/TR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)
PB11: U4.C4 (PB11/ESC0.P0_TXEN/PWM1.P3/TRGM.P11/ETH0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)
PB24: U4.A2 (PB24/ESC0.CTR4/XPI0.CA_CS1/SDM0.CLK3/ET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)
PB25: U4.B1 (PB25/ESC0.CTR5/XPI0.CA_DQS/SDM0.DAT3/ET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)
PB26: U4.3 (WP#/IO2), U4.A3 (PB26/ESC0.CTR6/XPI0.CA_D2/QEI1.H1/SDM0.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)
PB27: U4.5 (DI/IO0), U4.B2 (PB27/ESC0.CTR7/XPI0.CA_D0/QEI1.F/SDM0.D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)
PB28: U4.2 (DO/IO1), U4.A4 (PB28/ESC0.CTR8/XPI0.CA_D1/QEI1.H0/SDM0.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)
PB29: U4.6 (CLK), U4.B3 (PB29/XPI0.CA_SCLK/QEI1.Z/SDM0.DAT1/ETH0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)
PB30: R49.1, U4.1 (CS#), U4.A5 (PB30/ESC0.CTR7/XPI0.CA_CS0/QEI1.A/SDM0.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)
PB31: U4.7 (HOLD#/IO3), U4.B4 (PB31/ESC0.CTR8/XPI0.CA_D3/QEI1.B/SDM0.D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)
