RCIA-JASON13/kicad_tst/01_HPM5E00EVKRevC/01_工程文件/HPM5E00EVKRevC/09.POWER.kicad_sch

## KiCad design 01_HPM5E00EVKRevC/01_工程文件/HPM5E00EVKRevC/09.POWER.kicad_sch (2026-01-12)

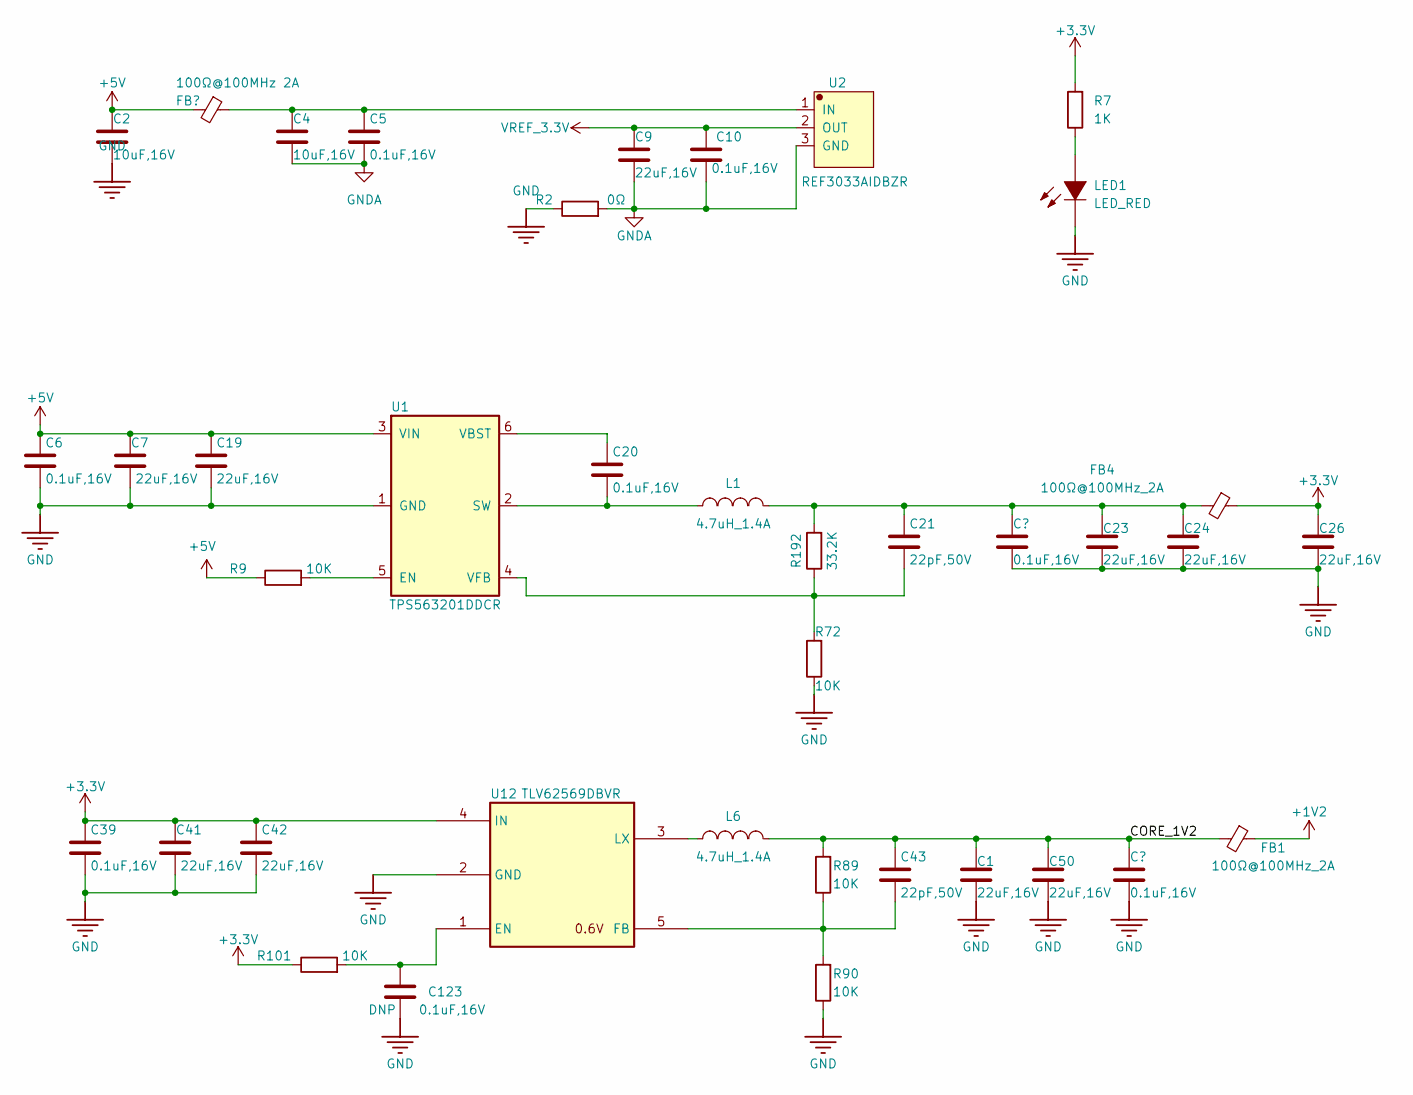
[picture p8: schematic 09.POWER.kicad_sch]

Parts:
C1, C7, C9, C19, C23, C24, C26, C41, C42, C50: 22uF,16V; C_0805_2012Metric
C2, C4: 10uF,16V; C_0603_1608Metric
C5, C6, C10, C20, C39, C74, C123: 0.1uF,16V; C_0402_1005Metric
C21, C43: 22pF,50V; C_0402_1005Metric
FB1, FB4: 100Ω@100MHz_2A; R_0805_2012Metric
FB2: 100Ω@100MHz 2A; R_0603_1608Metric
L1, L6: 4.7uH_1.4A; L1008
LED1: LED_RED; LED_0603
R2: 0Ω; R_0603_1608Metric
R7: 1K; R_0402_1005Metric
R9, R72, R89, R90, R101: 10K; R_0402_1005Metric
R192: 33.2K; R_0402_1005Metric
U1: TPS563201DDCR; SOT-23-6
U2: REF3033AIDBZR; SOT-23
U12: TLV62569DBVR; SOT-23-5

Connections:
+1V2: FB1.1
+3.3V: C26.1, C39.1, C41.1, C42.1, FB4.1, R7.2, R101.1, U12.4 (IN)
+5V: C2.1, C6.1, C7.1, C19.1, FB2.2, R9.1, U1.3 (VIN)
CORE_1V2: C1.1, C43.1, C50.1, C74.1, FB1.2, L6.2, R89.2
GND: C1.2, C2.2, C6.2, C7.2, C19.2, C23.2, C24.2, C26.2, C39.2, C41.2, C42.2, C50.2, C74.2, C123.2, LED1.1 (K), R2.1, R72.1, R90.1, U1.1 (GND), U12.2 (GND)
GNDA: C4.2, C5.2, C9.2, C10.2, R2.2, U2.3 (GND)
unnamed: C4.1, C5.1, FB2.1, U2.1 (IN)
unnamed: C20.1, U1.6 (VBST)
unnamed: C20.2, L1.1, U1.2 (SW)
unnamed: C21.1, C23.1, C24.1, C74.1, FB4.2, L1.2, R192.2
unnamed: C21.2, R72.2, R192.1, U1.4 (VFB)
unnamed: C43.2, R89.1, R90.2, U12.5 (FB)
unnamed: C123.1, R101.2, U12.1 (EN)
unnamed: L6.1, U12.3 (LX)
unnamed: LED1.2 (A), R7.1
unnamed: R9.2, U1.5 (EN)
VREF_3.3V: C9.1, C10.1, U2.2 (OUT)
