RCIA-JASON13/kicad_tst/01_HPM5E00EVKRevC/01_工程文件/HPM5E00EVKRevC/10.MISC.kicad_sch

## KiCad design 01_HPM5E00EVKRevC/01_工程文件/HPM5E00EVKRevC/10.MISC.kicad_sch (2026-01-12)

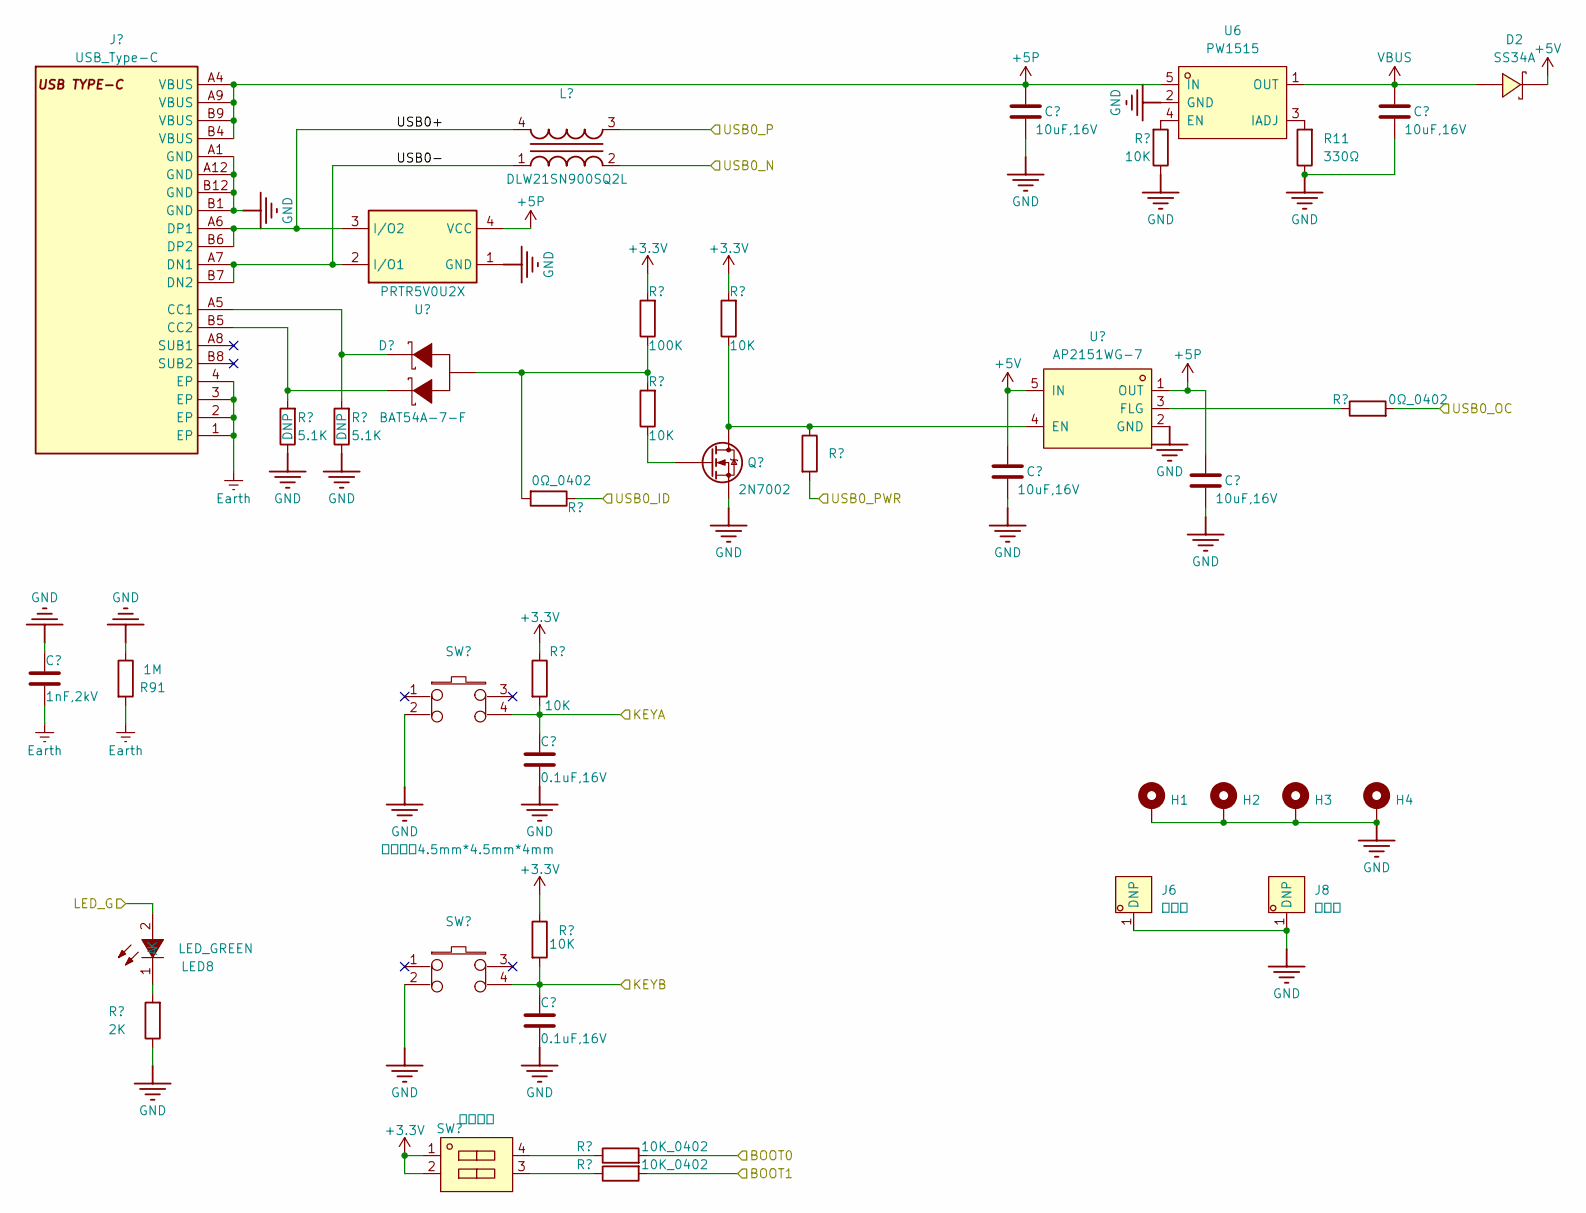
[picture p9: schematic 10.MISC.kicad_sch]

Parts:
C3, C8, C31, C60: 10uF,16V; C_0603_1608Metric
C32, C172: 0.1uF,16V; C_0402_1005Metric
C125: 1nF,2kV; C_1206_3216Metric
D2: SS34A; D_SMA
D3: BAT54A-7-F; SOT-23
H1, H2, H3, H4: MountingHole_Pad; FIX1
J1: USB_Type-C; TYPE-C-16P
J6, J8: 测试针; 探针
L2: DLW21SN900SQ2L; L2012
LED8: LED_GREEN; LED_0603
Q1: 2N7002; SOT-23
R10, R14, R16, R26, R59: 10K; R_0402_1005Metric
R11: 330Ω; R_0402_1005Metric
R12: 100K; R_0402_1005Metric
R13, R15, R20: 0Ω_0402; R_0402_1005Metric
R18, R19: 5.1K; R_0402_1005Metric
R21, R22: 10K_0402; R_0402_1005Metric
R24: 2K; R_0402_1005Metric
R91: 1M; R_1206_3216Metric
SW1: 拨码开关; SW-SMD_DM-02-V
SW2, SW5: 轻触开关4.5mm*4.5mm*4mm; 轻触开关SMD-4P,4.5x4.5mm
U6: PW1515; SOT-23-5
U7: PRTR5V0U2X; SOT-143
U8: AP2151WG-7; SOT-23-5

Connections:
+3.3V: R12.2, R14.2, R26.1, R59.1, SW1.1 (PIN1), SW1.2 (PIN2)
+5P: C8.1, C60.1, J1.A4 (VBUS), J1.A9 (VBUS), J1.B4 (VBUS), J1.B9 (VBUS), U6.5 (IN), U7.4 (VCC), U8.1 (OUT)
+5V: C31.1, D2.1 (K), U8.5 (IN)
BOOT0: R21.2
BOOT1: R22.2
Earth: C125.2, J1.1 (EP), J1.2 (EP), J1.3 (EP), J1.4 (EP), R91.2
GND: C3.2, C8.2, C31.2, C32.2, C60.2, C125.1, C172.2, H1.1, H2.1, H3.1, H4.1, J1.A1 (GND), J1.A12 (GND), J1.B1 (GND), J1.B12 (GND), J6.1, J8.1, Q1.2 (S), R10.1, R11.1, R18.1, R19.1, R24.1, R91.1, SW2.2, SW5.2, U6.2 (GND), U7.1 (GND), U8.2 (GND)
KEYA: C32.1, R26.2, SW2.4
KEYB: C172.1, R59.2, SW5.4
LED_G: LED8.2 (A)
unnamed: D3.1 (A), J1.A5 (CC1), R19.2
unnamed: D3.2 (A), J1.B5 (CC2), R18.2
unnamed: D3.3 (K), R12.1, R13.2, R16.2
unnamed: LED8.1 (K), R24.2
unnamed: Q1.1 (G), R16.1
unnamed: Q1.3 (D), R14.1, R15.1, U8.4 (EN)
unnamed: R10.2, U6.4 (EN)
unnamed: R11.2, U6.3 (IADJ)
unnamed: R20.1, U8.3 (FLG)
unnamed: R21.1, SW1.4 (PIN4)
unnamed: R22.1, SW1.3 (PIN3)
USB0+: J1.A6 (DP1), J1.B6 (DP2), L2.4, U7.3 (I/O2)
USB0-: J1.A7 (DN1), J1.B7 (DN2), L2.1, U7.2 (I/O1)
USB0_ID: R13.1
USB0_N: L2.2
USB0_OC: R20.2
USB0_P: L2.3
USB0_PWR: R15.2
VBUS: C3.1, D2.2 (A), U6.1 (OUT)
