RCIA-JASON13/kicad_tst/01_HPM5E00EVKRevC/01_工程文件/HPM5E00EVKRevC/11.ETHERCAT_P1.kicad_sch

## KiCad design 01_HPM5E00EVKRevC/01_工程文件/HPM5E00EVKRevC/11.ETHERCAT_P1.kicad_sch (2026-01-12)

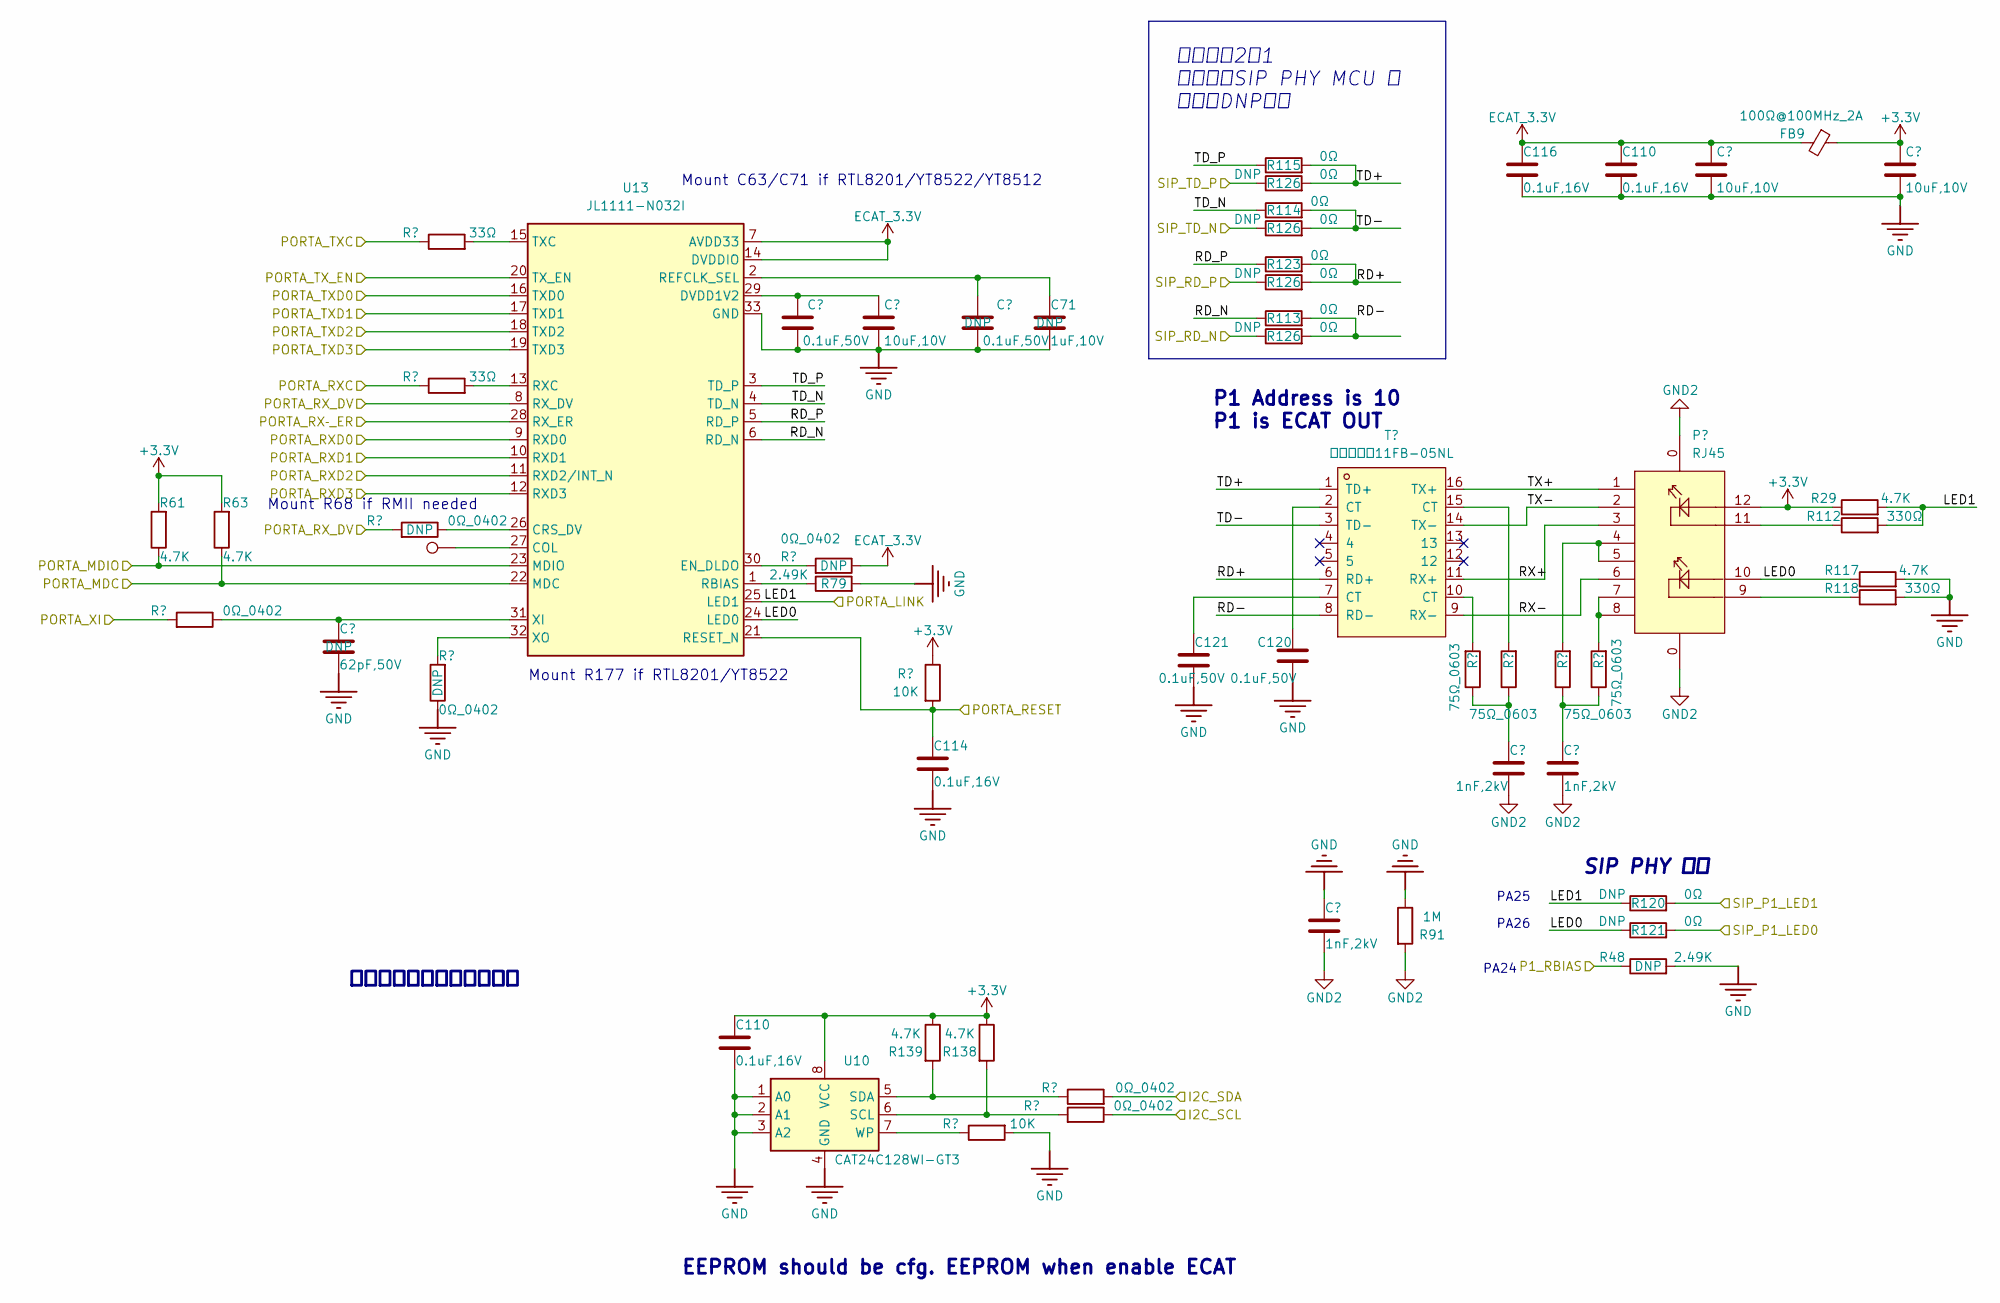
[picture p10: schematic 11.ETHERCAT_P1.kicad_sch]

Parts:
C71: 1uF,10V; C_0402_1005Metric
C110, C114, C116: 0.1uF,16V; C_0402_1005Metric
C118, C120, C121: 0.1uF,50V; C_0402_1005Metric
C122, C123, C125: 1nF,2kV; C_1206_3216Metric
C163: 62pF,50V; C_0402_1005Metric
C245: 10uF,10V; C_0402_1005Metric
FB9: 100Ω@100MHz_2A; R_0603_1608Metric
P2: RJ45; RJ45-TH_B-1-1_led-update
R29, R61, R63, R117, R138, R139: 4.7K; R_0402_1005Metric
R41, R129, R133, R134: 0Ω_0402; R_0402_1005Metric
R48, R79: 2.49K; R_0402_1005Metric
R91: 1M; R_1206_3216Metric
R112, R118: 330Ω; R_0402_1005Metric
R113, R114, R115, R120, R121, R123, R126: 0Ω; R_0402_1005Metric
R124, R125, R127: 75Ω_0603; R_0603_1608Metric
R128, R131: 10K; R_0402_1005Metric
R140: 33Ω; R_0402_1005Metric
T2: 网口变压器11FB-05NL; H1102_XFMR16_SM
TP7: 0.5mm; TestPoint_Pad_D0.5mm
U10: CAT24C128WI-GT3; SOIC-8
U13: JL1111-N032I; QFN-32-1EP_5x5mm_P0.5mm_EP3.1x3.1mm

Connections:
+3.3V: C110.1, C245.1, FB9.1, P2.12, R29.1, R61.2, R63.2, R128.1, R138.1, R139.1, U10.8 (VCC)
ECAT_3.3V: C110.1, C116.1, C245.1, FB9.2, R41.1, U13.7 (AVDD33), U13.14 (DVDDIO)
GND: C71.2, C110.2, C114.2, C116.2, C118.1, C120.1, C121.2, C125.1, C163.2, C245.2, R48.2, R79.2, R91.1, R117.2, R118.2, R129.1, R131.2, U10.1 (A0), U10.2 (A1), U10.3 (A2), U10.4 (GND), U13.33 (GND)
GND2: C122.2, C123.2, C125.2, P2.0 (S), R91.2
I2C_SCL: R133.1
I2C_SDA: R134.2
LED0: P2.10, R117.1, R121.1, U13.24 (LED0)
LED1: R29.2, R112.2, R120.1, U13.25 (LED1)
unnamed: C71.1, C118.2, C245.1, U13.2 (REFCLK_SEL), U13.29 (DVDD1V2)
unnamed: C120.2, T2.2 (CT)
unnamed: C121.1, T2.7 (CT)
unnamed: C122.1, R124.1, R125.1
unnamed: C123.1, R126.1, R127.1
unnamed: C163.1, R41.1, U13.31 (XI)
unnamed: P2.4, P2.5, R126.2
unnamed: P2.7, P2.8, R127.2
unnamed: P2.9, R118.1
unnamed: P2.11, R112.1
unnamed: R41.1, U13.26 (CRS_DV)
unnamed: R41.2, U13.30 (EN_DLDO)
unnamed: R79.1, U13.1 (RBIAS)
unnamed: R124.2, T2.10 (CT)
unnamed: R125.2, T2.15 (CT)
unnamed: R129.2, U13.32 (XO)
unnamed: R131.1, U10.7 (WP)
unnamed: R133.2, R138.2, U10.6 (SCL)
unnamed: R134.1, R139.2, U10.5 (SDA)
unnamed: R140.2, U13.13 (RXC), U13.15 (TXC)
unnamed: TP7.1, U13.27 (COL)
P1_RBIAS: R48.1
PORTA_MDC: R63.1, U13.22 (MDC)
PORTA_MDIO: R61.1, U13.23 (MDIO)
PORTA_RESET: C114.1, R128.2, U13.21 (RESET_N)
PORTA_RXC: R140.1
PORTA_RXD0: U13.9 (RXD0)
PORTA_RXD1: U13.10 (RXD1)
PORTA_RXD2: U13.11 (RXD2/INT_N)
PORTA_RXD3: U13.12 (RXD3)
PORTA_RX_DV: R41.2, U13.8 (RX_DV)
PORTA_RX­_ER: U13.28 (RX_ER)
PORTA_TXC: R140.1
PORTA_TXD0: U13.16 (TXD0)
PORTA_TXD1: U13.17 (TXD1)
PORTA_TXD2: U13.18 (TXD2)
PORTA_TXD3: U13.19 (TXD3)
PORTA_TX_EN: U13.20 (TX_EN)
PORTA_XI: R41.2
RD+: R123.2, R126.2, T2.6 (RD+)
RD-: R113.2, R126.2, T2.8 (RD-)
RD_N: R113.1, U13.6 (RD_N)
RD_P: R123.1, U13.5 (RD_P)
RX+: P2.3, T2.11 (RX+)
RX-: P2.6, T2.9 (RX-)
SIP_P1_LED0: R121.2
SIP_P1_LED1: R120.2
SIP_RD_N: R126.1
SIP_RD_P: R126.1
SIP_TD_N: R126.1
SIP_TD_P: R126.1
TD+: R115.2, R126.2, T2.1 (TD+)
TD-: R114.2, R126.2, T2.3 (TD-)
TD_N: R114.1, U13.4 (TD_N)
TD_P: R115.1, U13.3 (TD_P)
TX+: P2.1, T2.16 (TX+)
TX-: P2.2, T2.14 (TX-)

Notes on the sheet:
PA25
Mount R68 if RMII needed
电阻焊接2选1 如果测试SIP PHY MCU ， 焊接带DNP电阻
Mount R177 if RTL8201/YT8522
SIP PHY 使用
PA26
Mount C63/C71 if RTL8201/YT8522/YT8512
P1 Address is 10 P1 is ECAT OUT
建议客户使用景略上述料号
PA24
EEPROM should be cfg. EEPROM when enable ECAT
