RCIA-JASON13/kicad_tst/01_HPM5E00EVKRevC/01_工程文件/HPM5E00EVKRevC/12.ETHERCAT_P0.kicad_sch

## KiCad design 01_HPM5E00EVKRevC/01_工程文件/HPM5E00EVKRevC/12.ETHERCAT_P0.kicad_sch (2026-01-12)

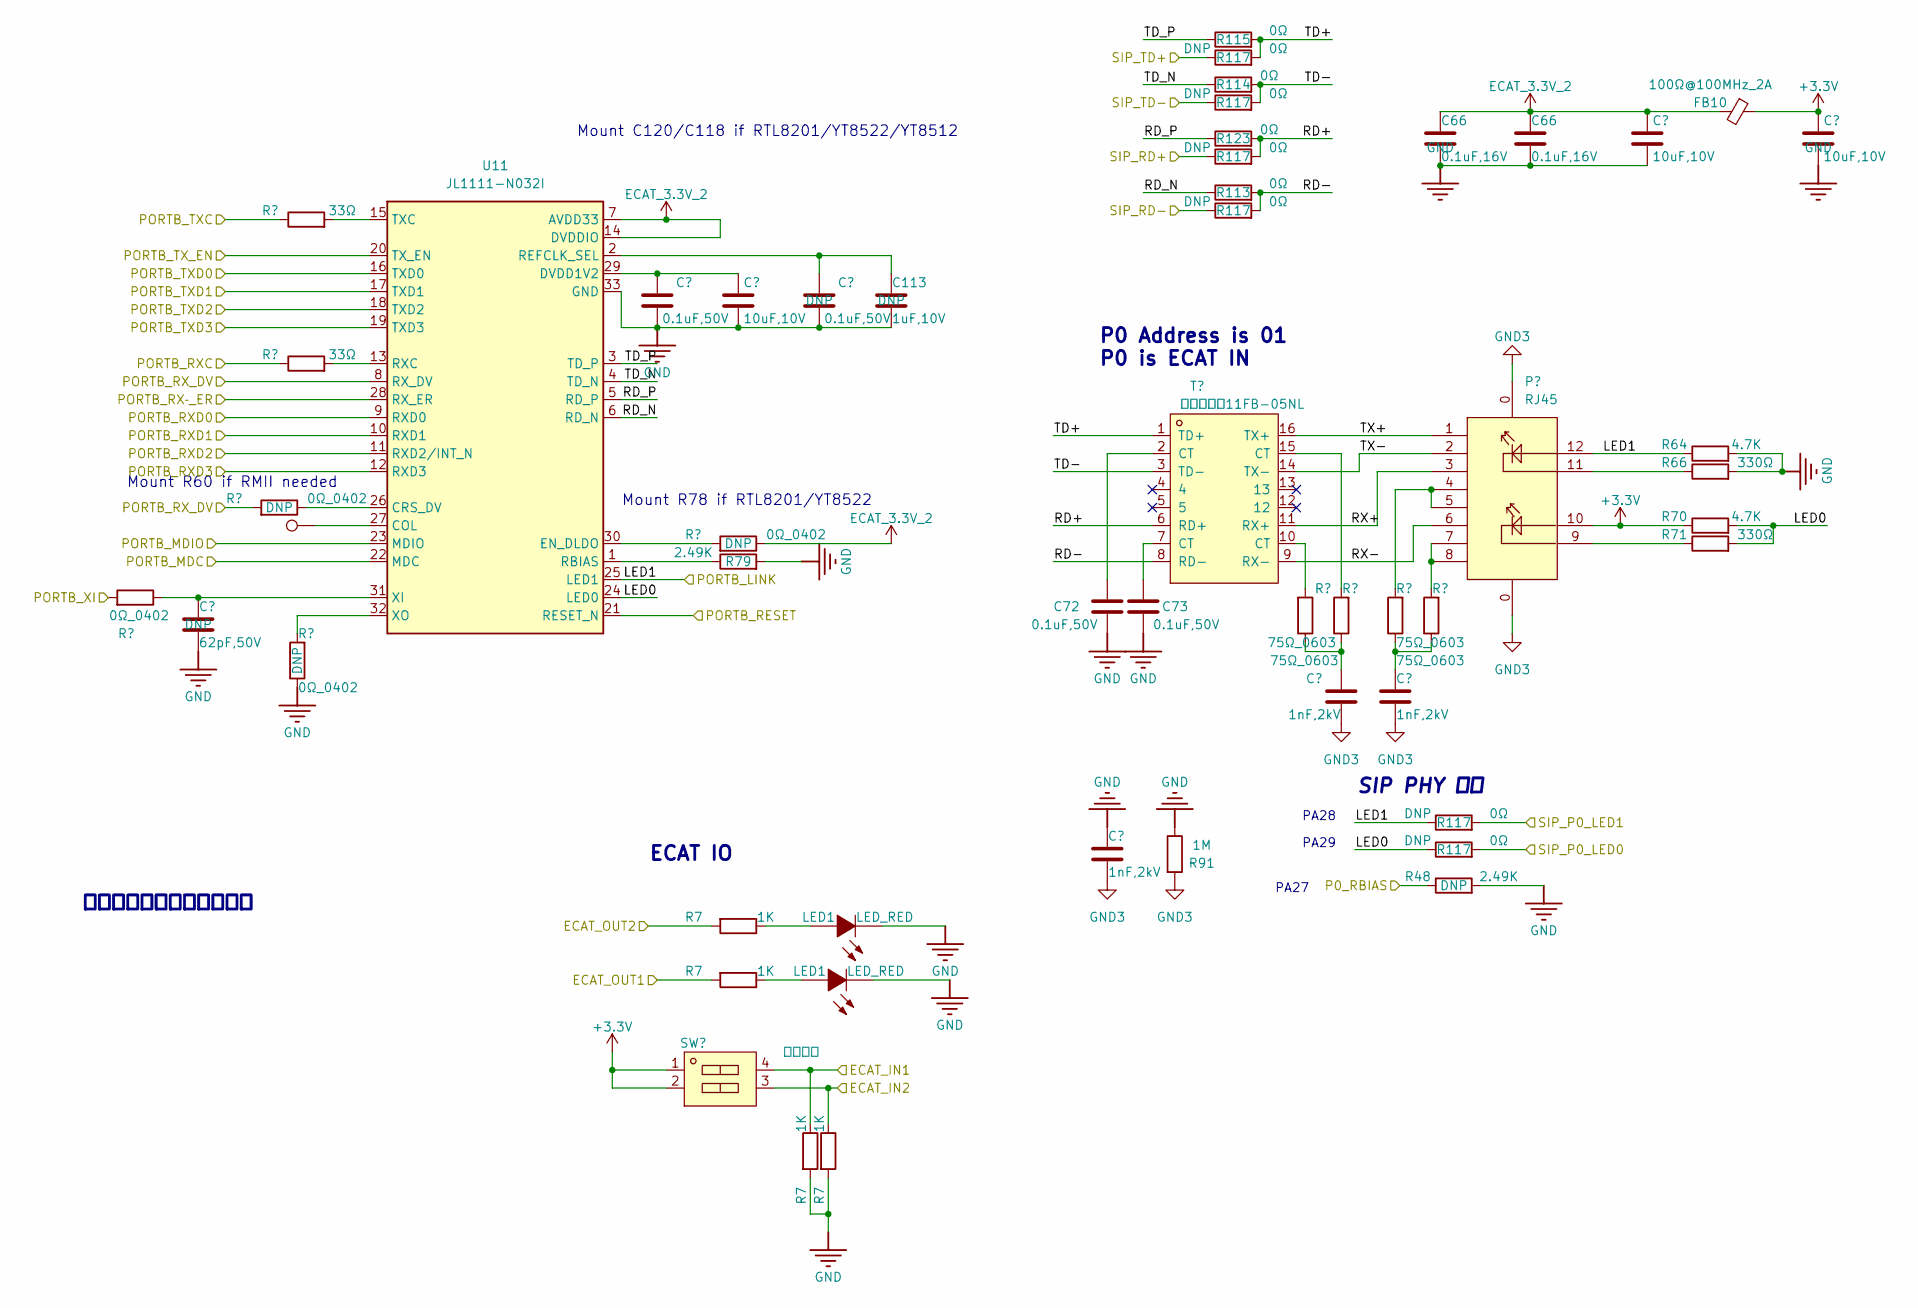
[picture p11: schematic 12.ETHERCAT_P0.kicad_sch]

Parts:
C66: 0.1uF,16V; C_0402_1005Metric
C70, C72, C73, C112: 0.1uF,50V; C_0402_1005Metric
C74, C75, C77: 1nF,2kV; C_1206_3216Metric
C113: 1uF,10V; C_0402_1005Metric
C163: 62pF,50V; C_0402_1005Metric
C245: 10uF,10V; C_0402_1005Metric
FB10: 100Ω@100MHz_2A; R_0603_1608Metric
LED1: LED_RED; LED_0603
P1: RJ45; RJ45-TH_B-1-1_led-update
R7: 1K; R_0402_1005Metric
R40, R82, R119: 0Ω_0402; R_0402_1005Metric
R48, R79: 2.49K; R_0402_1005Metric
R64, R70: 4.7K; R_0402_1005Metric
R66, R71: 330Ω; R_0402_1005Metric
R77, R78, R80: 75Ω_0603; R_0603_1608Metric
R91: 1M; R_1206_3216Metric
R113, R114, R115, R117, R123: 0Ω; R_0402_1005Metric
R140: 33Ω; R_0402_1005Metric
SW1: 拨码开关; SW-SMD_DM-02-V
T1: 网口变压器11FB-05NL; H1102_XFMR16_SM
T29: 0.5mm; TestPoint_Pad_D0.5mm
U11: JL1111-N032I; QFN-32-1EP_5x5mm_P0.5mm_EP3.1x3.1mm

Connections:
+3.3V: C245.1, FB10.1, P1.10, R70.1, SW1.1 (PIN1), SW1.2 (PIN2)
ECAT_3.3V_2: C66.1, C245.1, FB10.2, R119.1, U11.7 (AVDD33), U11.14 (DVDDIO)
ECAT_IN1: R7.1, SW1.4 (PIN4)
ECAT_IN2: R7.1, SW1.3 (PIN3)
ECAT_OUT1: R7.2
ECAT_OUT2: R7.2
GND: C66.2, C70.1, C72.1, C73.2, C77.1, C112.1, C113.2, C163.2, C245.2, LED1.1 (K), R7.2, R48.2, R64.2, R66.2, R79.2, R82.1, R91.1, U11.33 (GND)
GND3: C74.2, C75.2, C77.2, P1.0 (S), R91.2
LED0: R70.2, R71.2, R117.1, U11.24 (LED0)
LED1: P1.12, R64.1, R117.1, U11.25 (LED1)
unnamed: C72.2, T1.2 (CT)
unnamed: C73.1, T1.7 (CT)
unnamed: C74.1, R77.1, R78.1
unnamed: C75.1, R79.1, R80.1
unnamed: C112.2, C113.1, U11.2 (REFCLK_SEL)
unnamed: C163.1, R40.1, U11.31 (XI)
unnamed: C70.2, C245.1, U11.29 (DVDD1V2)
unnamed: LED1.2 (A), R7.1
unnamed: P1.4, P1.5, R79.2
unnamed: P1.7, P1.8, R80.2
unnamed: P1.9, R71.1
unnamed: P1.11, R66.1
unnamed: R77.2, T1.10 (CT)
unnamed: R78.2, T1.15 (CT)
unnamed: R79.1, U11.1 (RBIAS)
unnamed: R82.2, U11.32 (XO)
unnamed: R119.1, U11.26 (CRS_DV)
unnamed: R119.2, U11.30 (EN_DLDO)
unnamed: R140.2, U11.13 (RXC), U11.15 (TXC)
unnamed: T29.1, U11.27 (COL)
P0_RBIAS: R48.1
PORTB_MDC: U11.22 (MDC)
PORTB_MDIO: U11.23 (MDIO)
PORTB_RESET: U11.21 (RESET_N)
PORTB_RXC: R140.1
PORTB_RXD0: U11.9 (RXD0)
PORTB_RXD1: U11.10 (RXD1)
PORTB_RXD2: U11.11 (RXD2/INT_N)
PORTB_RXD3: U11.12 (RXD3)
PORTB_RX_DV: R119.2, U11.8 (RX_DV)
PORTB_RX­_ER: U11.28 (RX_ER)
PORTB_TXC: R140.1
PORTB_TXD0: U11.16 (TXD0)
PORTB_TXD1: U11.17 (TXD1)
PORTB_TXD2: U11.18 (TXD2)
PORTB_TXD3: U11.19 (TXD3)
PORTB_TX_EN: U11.20 (TX_EN)
PORTB_XI: R40.2
RD+: R117.2, R123.2, T1.6 (RD+)
RD-: R113.2, R117.2, T1.8 (RD-)
RD_N: R113.1, U11.6 (RD_N)
RD_P: R123.1, U11.5 (RD_P)
RX+: P1.3, T1.11 (RX+)
RX-: P1.6, T1.9 (RX-)
SIP_P0_LED0: R117.2
SIP_P0_LED1: R117.2
SIP_RD+: R117.1
SIP_RD-: R117.1
SIP_TD+: R117.1
SIP_TD-: R117.1
TD+: R115.2, R117.2, T1.1 (TD+)
TD-: R114.2, R117.2, T1.3 (TD-)
TD_N: R114.1, U11.4 (TD_N)
TD_P: R115.1, U11.3 (TD_P)
TX+: P1.1, T1.16 (TX+)
TX-: P1.2, T1.14 (TX-)

Notes on the sheet:
SIP PHY 使用
PA27
PA29
建议客户使用景略上述料号
P0 Address is 01 P0 is ECAT IN
ECAT IO
Mount R78 if RTL8201/YT8522
PA28
Mount R60 if RMII needed
Mount C120/C118 if RTL8201/YT8522/YT8512
