RCIA-JASON13/kicad_tst/01_HPM5E00EVKRevC/01_工程文件/HPM5E00EVKRevC/14.ADC_CAN.kicad_sch

## KiCad design 01_HPM5E00EVKRevC/01_工程文件/HPM5E00EVKRevC/14.ADC_CAN.kicad_sch (2026-01-12)

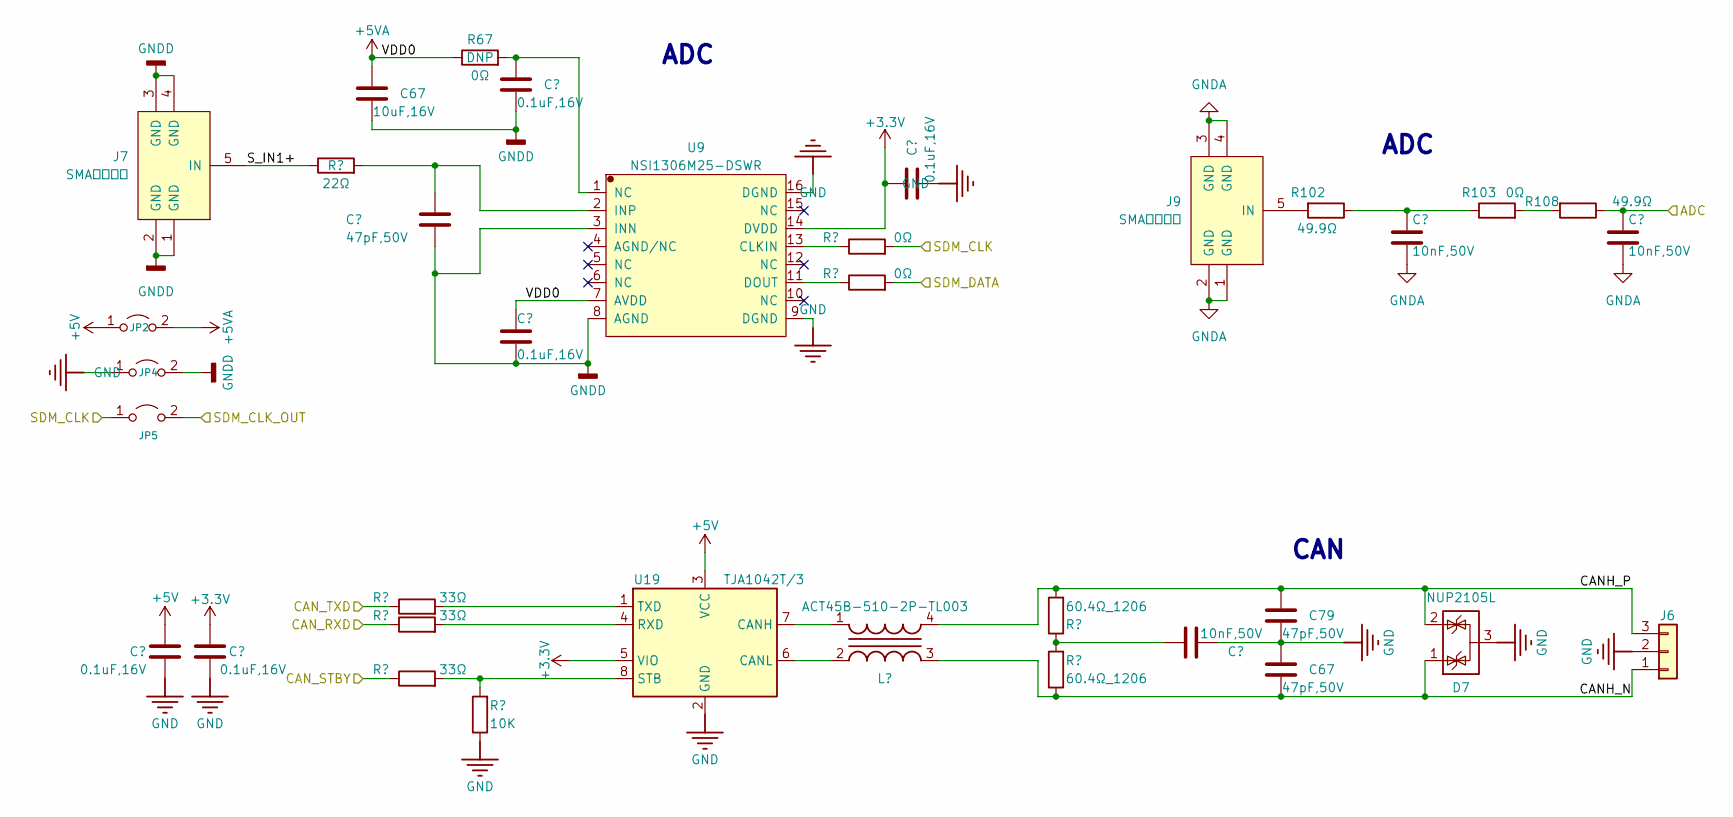
[picture p13: schematic 14.ADC_CAN.kicad_sch]

Parts:
C66, C83, C87, C172, C173: 0.1uF,16V; C_0402_1005Metric
C67, C79, C86: 47pF,50V; C_0402_1005Metric
C145: 10nF,50V; C_0402_1005Metric
D7: NUP2105L; SOT-23
J6: KF2EDGR_3.81_3P; PhoenixContact_MC_1,5_3-G-3.81_1x03_P3.81mm_Horizontal
J7, J9: SMA内孔弯座; SMA-弯座
JP2, JP4, JP5: Jumper_2; PinHeader_1x02_P2.54mm_Vertical
L8: ACT45B-510-2P-TL003; L4532
R5, R43, R45: 33Ω; R_0402_1005Metric
R58: 10K; R_0402_1005Metric
R59, R60: 60.4Ω_1206; R_1206_3216Metric
R67: 0Ω; R_0603_1608Metric
R73: 22Ω; R_0402_1005Metric
R74, R75, R103: 0Ω; R_0402_1005Metric
R102, R108: 49.9Ω; R_0402_1005Metric
U9: NSI1306M25-DSWR; SOP-16_L10.3-W7.5-P1.27-LS10.4-BL
U19: TJA1042T/3; SOIC-8

Connections:
+3.3V: C83.1, C172.1, U9.14 (DVDD), U19.5 (VIO)
+5V: C173.2, JP2.1 (A), U19.3 (VCC)
+5VA: C67.1, C87.1, JP2.2 (B), R67.1, U9.7 (AVDD)
ADC: C145.1, R108.2
CANH_N: C67.2, D7.1 (K), J6.1, L8.3, R60.1
CANH_P: C79.1, D7.2 (K), J6.3, L8.4, R59.2
CAN_RXD: R43.1
CAN_STBY: R45.1
CAN_TXD: R5.1
GND: C67.1, C79.2, C83.2, C145.2, C172.2, C173.1, D7.3 (A), J6.2, JP4.1 (A), R58.1, U9.9 (DGND), U9.16 (DGND), U19.2 (GND)
GNDA: C145.2, J9.1 (GND), J9.2 (GND), J9.3 (GND), J9.4 (GND)
GNDD: C66.2, C67.2, C86.2, C87.2, J7.1 (GND), J7.2 (GND), J7.3 (GND), J7.4 (GND), JP4.2 (B), U9.3 (INN), U9.8 (AGND)
unnamed: C66.1, R67.2, U9.1 (NC)
unnamed: C86.1, R73.2, U9.2 (INP)
unnamed: C145.1, R59.1, R60.2, R102.2, R103.1
unnamed: J9.5 (IN), R102.1
unnamed: L8.1, U19.7 (CANH)
unnamed: L8.2, U19.6 (CANL)
unnamed: R5.2, U19.1 (TXD)
unnamed: R43.2, U19.4 (RXD)
unnamed: R45.2, R58.2, U19.8 (STB)
unnamed: R74.1, U9.13 (CLKIN)
unnamed: R75.1, U9.11 (DOUT)
unnamed: R103.2, R108.1
SDM_CLK: JP5.1 (A), R74.2
SDM_CLK_OUT: JP5.2 (B)
SDM_DATA: R75.2
S_IN1+: J7.5 (IN), R73.1

Notes on the sheet:
ADC
CAN
