RCIA-JASON13/kicad_tst/01_HPM5E00EVKRevC/01_工程文件/HPM5E00EVKRevC/15.MOTOR_IF.kicad_sch

## KiCad design 01_HPM5E00EVKRevC/01_工程文件/HPM5E00EVKRevC/15.MOTOR_IF.kicad_sch (2026-01-12)

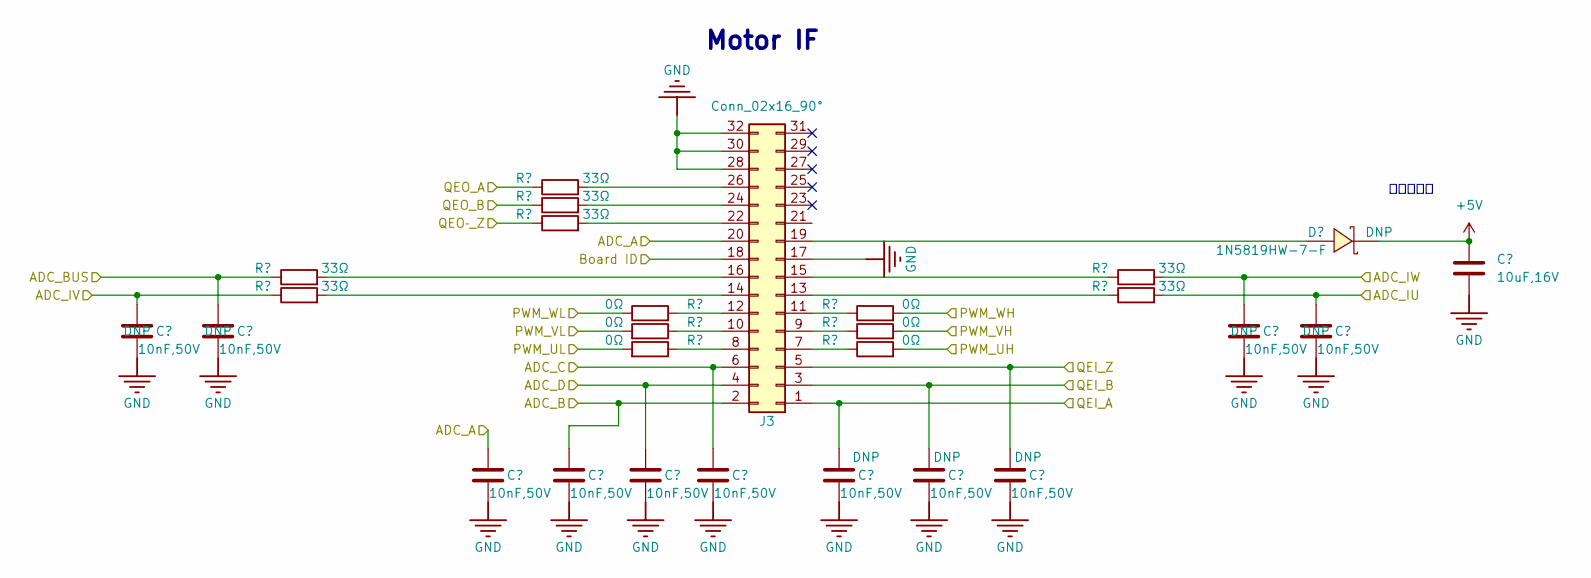
[picture p14: schematic 15.MOTOR_IF.kicad_sch]

Parts:
C30: 10uF,16V; C_0603_1608Metric
C55, C56, C61, C64, C126, C128, C151, C157, C158, C159, C160: 10nF,50V; C_0402_1005Metric
D1: 1N5819HW-7-F; D_SOD-123
J3: Conn_02x16_90°; PinHeader_2x16_P2.54mm_Horizontal
R43, R44, R45, R47, R194, R195, R196: 33Ω; R_0402_1005Metric
R48, R51, R75, R102, R103, R108: 0Ω; R_0402_1005Metric

Connections:
+5V: C30.1, D1.1 (K)
ADC_A: C160.1, J3.20
ADC_B: C157.1, J3.2
ADC_BUS: C56.1, R43.1
ADC_C: C159.1, J3.6
ADC_D: C158.1, J3.4
ADC_IU: C64.1, R47.2
ADC_IV: C55.1, R45.1
ADC_IW: C61.1, R44.2
Board ID: J3.18
GND: C30.2, C55.2, C56.2, C61.2, C64.2, C126.2, C128.2, C151.2, C157.2, C158.2, C159.2, C160.2, J3.17, J3.28, J3.30, J3.32
unnamed: D1.2 (A), J3.19
unnamed: J3.7, R108.1
unnamed: J3.8, R103.1
unnamed: J3.9, R102.1
unnamed: J3.10, R75.1
unnamed: J3.11, R51.1
unnamed: J3.12, R48.2
unnamed: J3.13, R47.1
unnamed: J3.14, R45.2
unnamed: J3.15, R44.1
unnamed: J3.16, R43.2
unnamed: J3.22, R196.2
unnamed: J3.24, R195.2
unnamed: J3.26, R194.2
PWM_UH: R108.2
PWM_UL: R103.2
PWM_VH: R102.2
PWM_VL: R75.2
PWM_WH: R51.2
PWM_WL: R48.1
QEI_A: C126.1, J3.1
QEI_B: C128.1, J3.3
QEI_Z: C151.1, J3.5
QEO_A: R194.1
QEO_B: R195.1
QEO­_Z: R196.1

Notes on the sheet:
Motor IF
电机板供电
