RCIA-JASON13/kicad_tst/01_HPM5E00EVKRevC/01_工程文件/HPM5E00EVKRevC/16.PPI.kicad_sch

## KiCad design 01_HPM5E00EVKRevC/01_工程文件/HPM5E00EVKRevC/16.PPI.kicad_sch (2026-01-12)

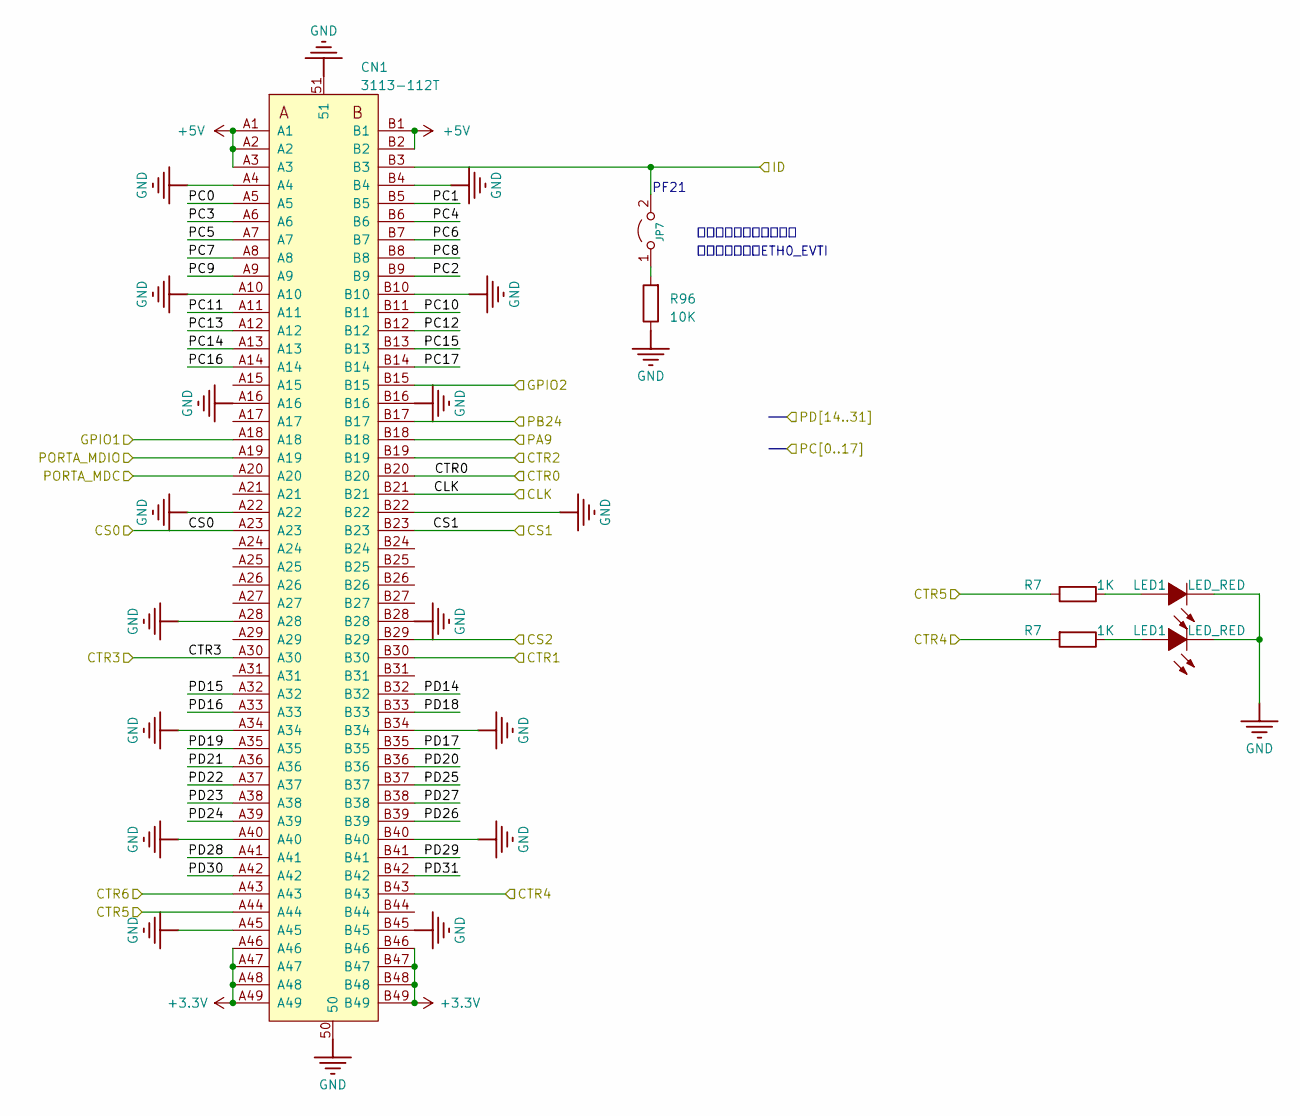
[picture p15: schematic 16.PPI.kicad_sch]

Parts:
CN1: 3113-112T; CONN-SMD_98P-P1.00-V_3133
JP7: Jumper_2; PinHeader_1x02_P2.54mm_Vertical
LED1: LED_RED; LED_0603
R7: 1K; R_0402_1005Metric
R96: 10K; R_0402_1005Metric

Connections:
+3.3V: CN1.A46, CN1.A47, CN1.A48, CN1.A49, CN1.B46, CN1.B47, CN1.B48, CN1.B49
+5V: CN1.A1, CN1.A2, CN1.A3, CN1.B1, CN1.B2
CLK: CN1.B21
CS0: CN1.A23
CS1: CN1.B23
CS2: CN1.B29
CTR0: CN1.B20
CTR1: CN1.B30
CTR2: CN1.B19
CTR3: CN1.A30
CTR4: CN1.B43, R7.2
CTR5: CN1.A44, R7.2
CTR6: CN1.A43
GND: CN1.50, CN1.51, CN1.A4, CN1.A10, CN1.A16, CN1.A22, CN1.A28, CN1.A34, CN1.A40, CN1.A45, CN1.B4, CN1.B10, CN1.B16, CN1.B22, CN1.B28, CN1.B34, CN1.B40, CN1.B45, LED1.1 (K), R96.1
GPIO1: CN1.A18
GPIO2: CN1.B15
ID: CN1.B3, JP7.2 (B)
unnamed: JP7.1 (A), R96.2
unnamed: LED1.2 (A), R7.1
PA9: CN1.B18
PB24: CN1.B17
PC0: CN1.A5
PC1: CN1.B5
PC2: CN1.B9
PC3: CN1.A6
PC4: CN1.B6
PC5: CN1.A7
PC6: CN1.B7
PC7: CN1.A8
PC8: CN1.B8
PC9: CN1.A9
PC10: CN1.B11
PC11: CN1.A11
PC12: CN1.B12
PC13: CN1.A12
PC14: CN1.A13
PC15: CN1.B13
PC16: CN1.A14
PC17: CN1.B14
PD14: CN1.B32
PD15: CN1.A32
PD16: CN1.A33
PD17: CN1.B35
PD18: CN1.B33
PD19: CN1.A35
PD20: CN1.B36
PD21: CN1.A36
PD22: CN1.A37
PD23: CN1.A38
PD24: CN1.A39
PD25: CN1.B37
PD26: CN1.B39
PD27: CN1.B38
PD28: CN1.A41
PD29: CN1.B41
PD30: CN1.A42
PD31: CN1.B42
PORTA_MDC: CN1.A20
PORTA_MDIO: CN1.A19

Notes on the sheet:
插上跳冒，默认检测板子
拔掉调帽，测试ETH0_EVTI
PF21
