RCIA-JASON13/kicad_tst/01_HPM5E00EVKRevC/01_工程文件/HPM5E00EVKRevC/18.EUI_OWR.kicad_sch

## KiCad design 01_HPM5E00EVKRevC/01_工程文件/HPM5E00EVKRevC/18.EUI_OWR.kicad_sch (2026-01-12)

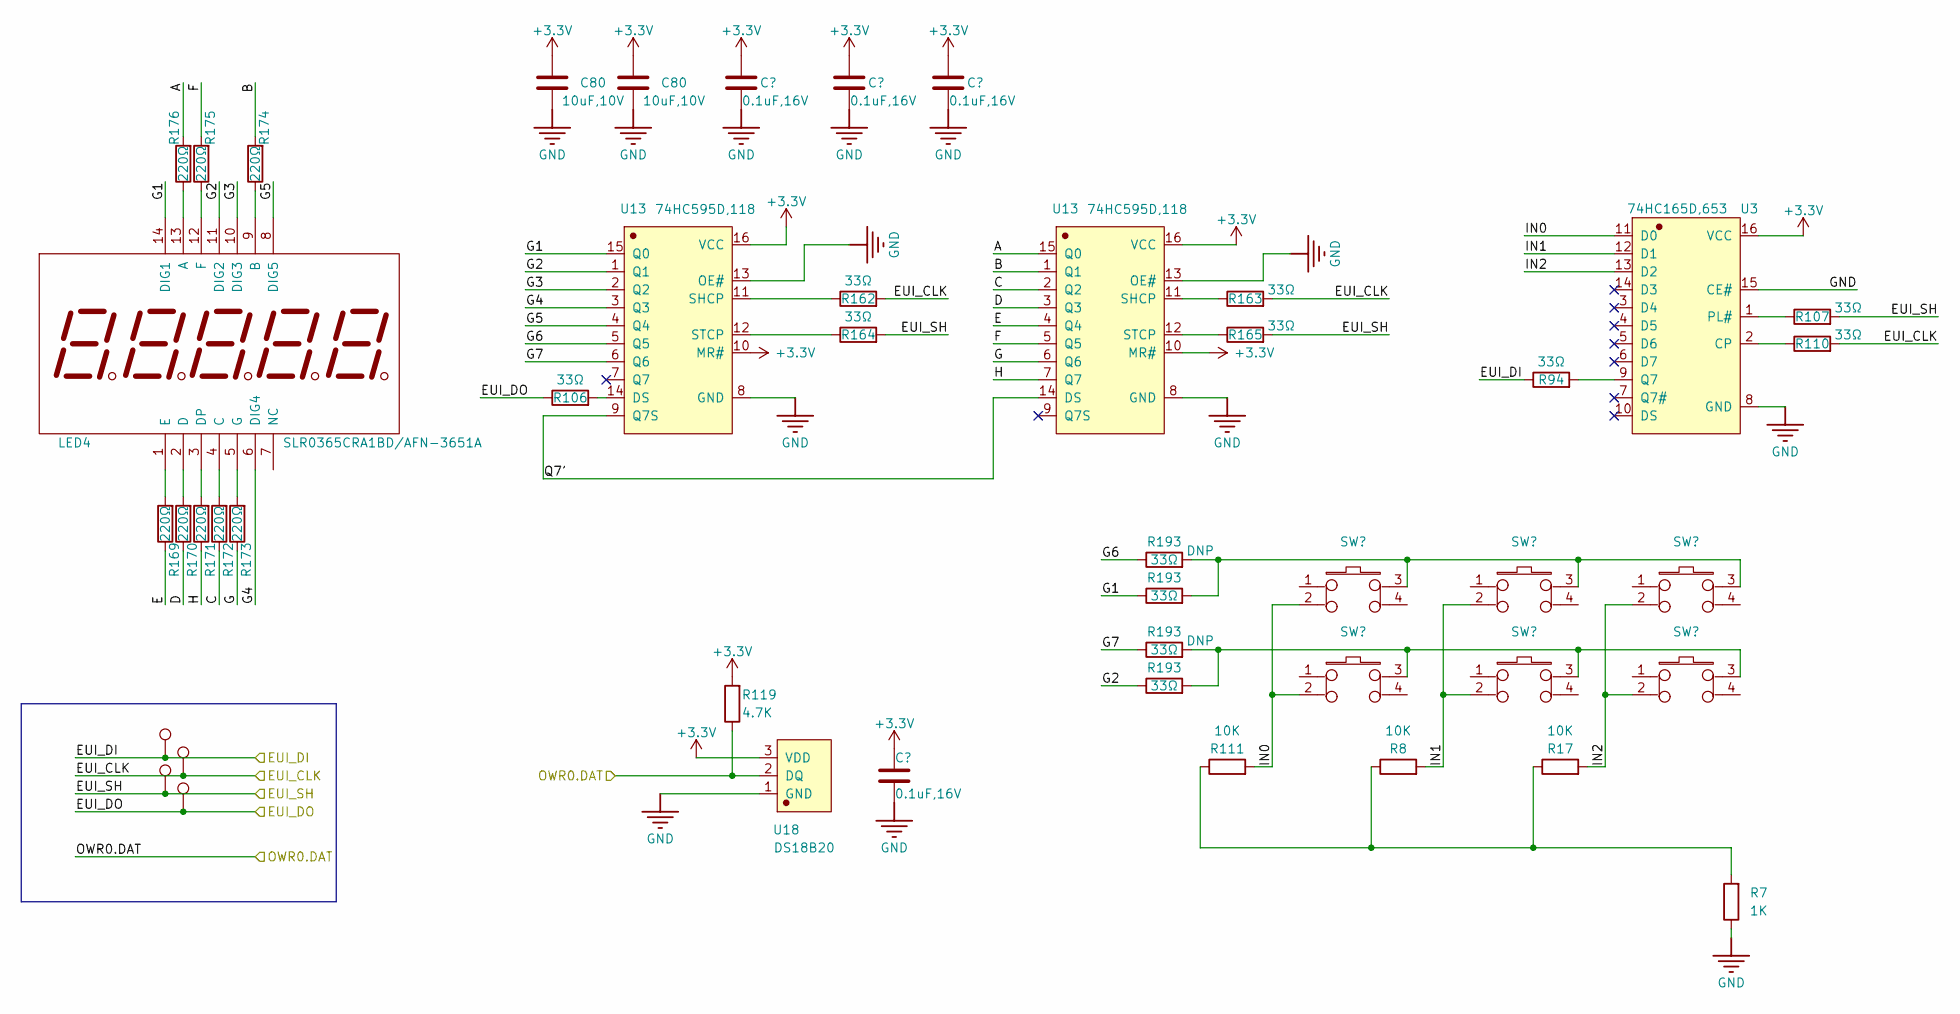
[picture p16: schematic 18.EUI_OWR.kicad_sch]

Parts:
C74: 0.1uF,16V; C_0402_1005Metric
C80: 10uF,10V; C_0402_1005Metric
LED4: SLR0365CRA1BD/AFN-3651A; LED-SEG-TH
R7: 1K; R_0402_1005Metric
R8, R17, R111: 10K; R_0402_1005Metric
R94, R106, R107, R110, R162, R163, R164, R165, R193: 33Ω; R_0402_1005Metric
R119: 4.7K; R_0603_1608Metric
R169, R170, R171, R172, R173, R174, R175, R176: 220Ω; R_0402_1005Metric
SW5: 轻触开关4.5mm*4.5mm*4mm; 轻触开关SMD-4P,4.5x4.5mm
TP41, TP43, TP44, TP45: 0.5mm; TestPoint_Pad_D0.5mm
U3: 74HC165D,653; SOIC-16
U13: 74HC595D,118; SOIC-16
U18: DS18B20; TO-92-3

Connections:
+3.3V: C74.1, C80.1, R119.2, U3.16 (VCC), U13.10 (MR#), U13.16 (VCC), U18.3 (VDD)
A: R176.2, U13.15 (Q0)
B: R174.2, U13.1 (Q1)
C: R172.1, U13.2 (Q2)
D: R170.1, U13.3 (Q3)
E: R169.1, U13.4 (Q4)
EUI_CLK: R110.2, R162.2, R163.2, TP43.1
EUI_DI: R94.1, TP41.1
EUI_DO: R106.1, TP45.1
EUI_SH: R107.2, R164.2, R165.2, TP44.1
F: R175.2, U13.5 (Q5)
G: R173.1, U13.6 (Q6)
G1: LED4.14 (DIG1), R193.1, U13.15 (Q0)
G2: LED4.11 (DIG2), R193.1, U13.1 (Q1)
G3: LED4.10 (DIG3), U13.2 (Q2)
G4: LED4.6 (DIG4), U13.3 (Q3)
G5: LED4.8 (DIG5), U13.4 (Q4)
G6: R193.1, U13.5 (Q5)
G7: R193.1, U13.6 (Q6)
GND: C74.2, C80.2, R7.1, U3.8 (GND), U3.15 (CE#), U13.8 (GND), U13.13 (OE#), U18.1 (GND)
H: R171.1, U13.7 (Q7)
IN0: R111.2, SW5.2, U3.11 (D0)
IN1: R8.2, SW5.2, U3.12 (D1)
IN2: R17.2, SW5.2, U3.13 (D2)
unnamed: LED4.1 (E), R169.2
unnamed: LED4.2 (D), R170.2
unnamed: LED4.3 (DP), R171.2
unnamed: LED4.4 (C), R172.2
unnamed: LED4.5 (G), R173.2
unnamed: LED4.9 (B), R174.1
unnamed: LED4.12 (F), R175.1
unnamed: LED4.13 (A), R176.1
unnamed: R94.2, U3.9 (Q7)
unnamed: R106.2, U13.14 (DS)
unnamed: R107.1, U3.1 (PL#)
unnamed: R110.1, U3.2 (CP)
unnamed: R7.2, R8.1, R17.1, R111.1
unnamed: R162.1, U13.11 (SHCP)
unnamed: R163.1, U13.11 (SHCP)
unnamed: R164.1, U13.12 (STCP)
unnamed: R165.1, U13.12 (STCP)
unnamed: R193.2, SW5.3
OWR0.DAT: R119.1, U18.2 (DQ)
Q7': U13.9 (Q7S), U13.14 (DS)
